Jpwolfe9912/Autodrone_V2/PNGs/3D_Front.png

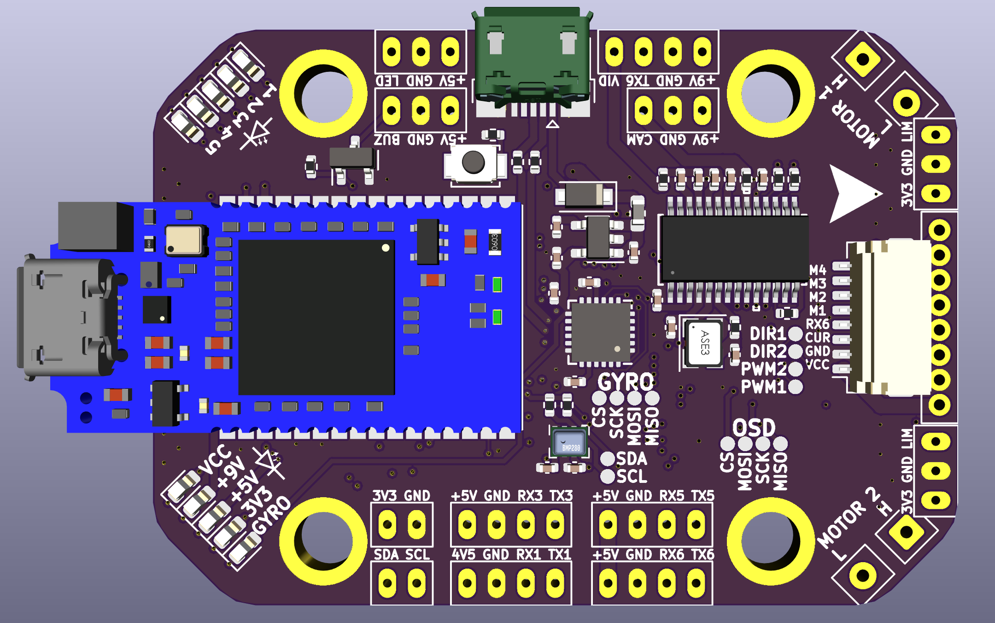
PNGs/3D_Front.png
