Jpwolfe9912/Autodrone_V2/README.md

# F722 Flight Controller V4
3D_Front
3D_Back
