Jpwolfe9912/Autodrone_V2/PNGs/3D_Back.png

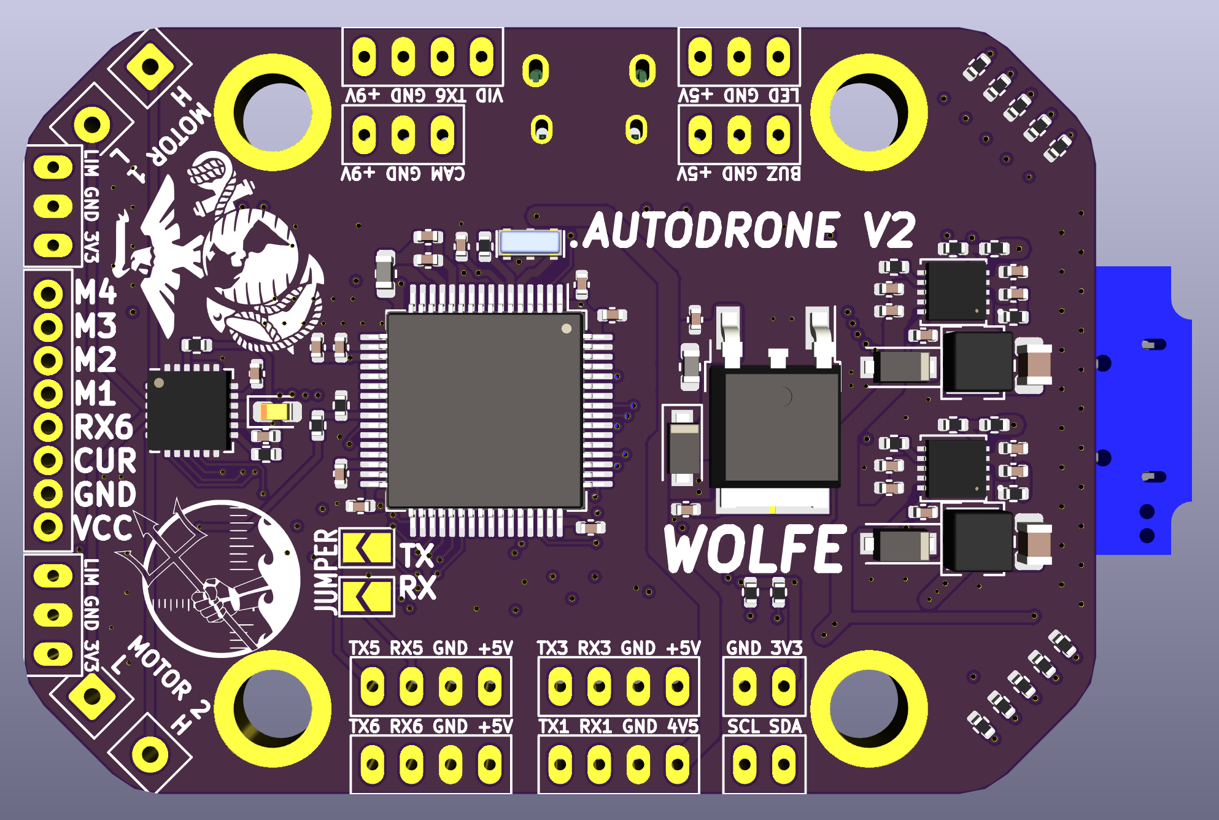
PNGs/3D_Back.png
