Jpwolfe9912/Autodrone_V2/PNGs/BMP280.png

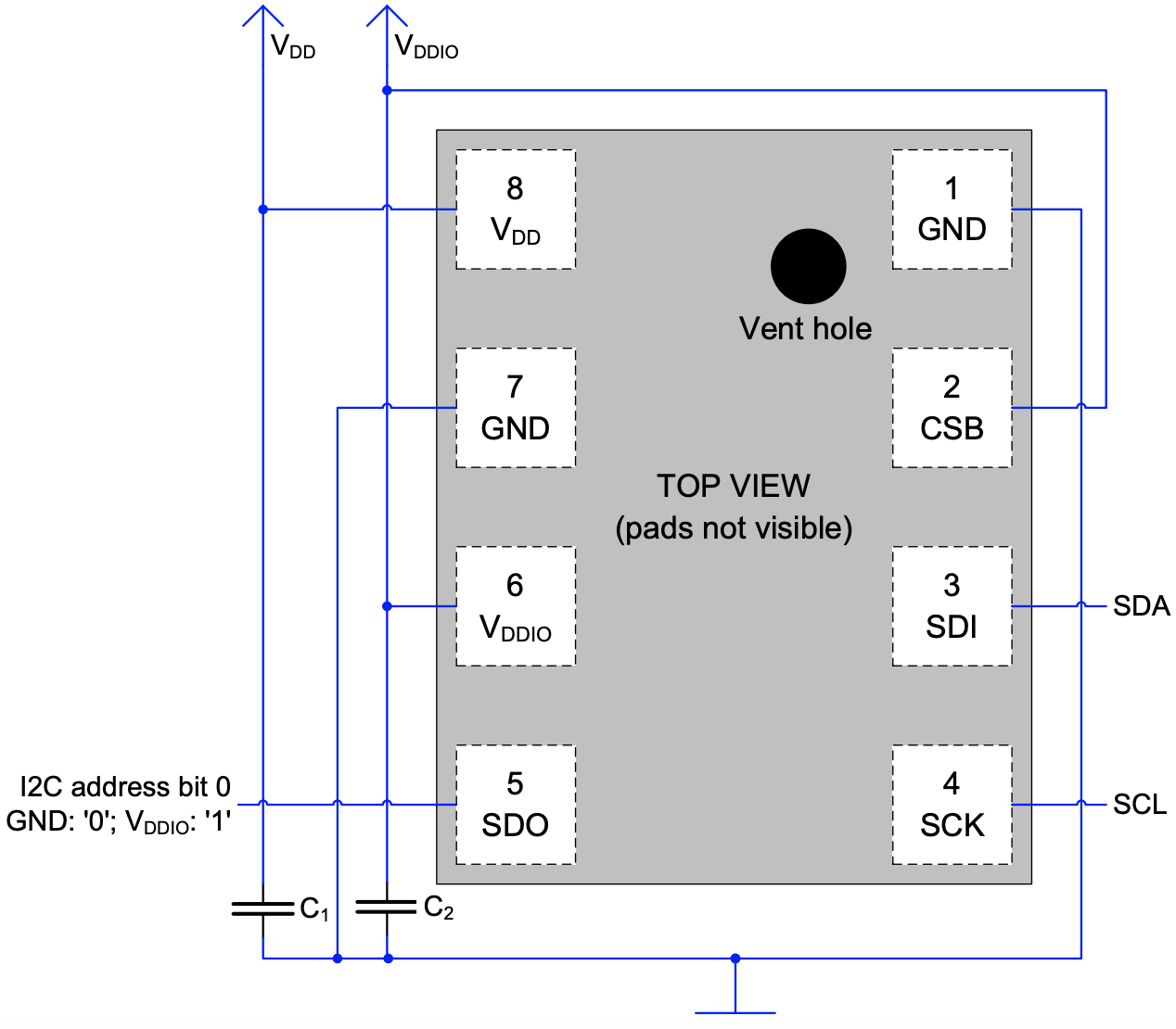
PNGs/BMP280.png
