Jpwolfe9912/Autodrone_V2/PNGs/DRV8424.png

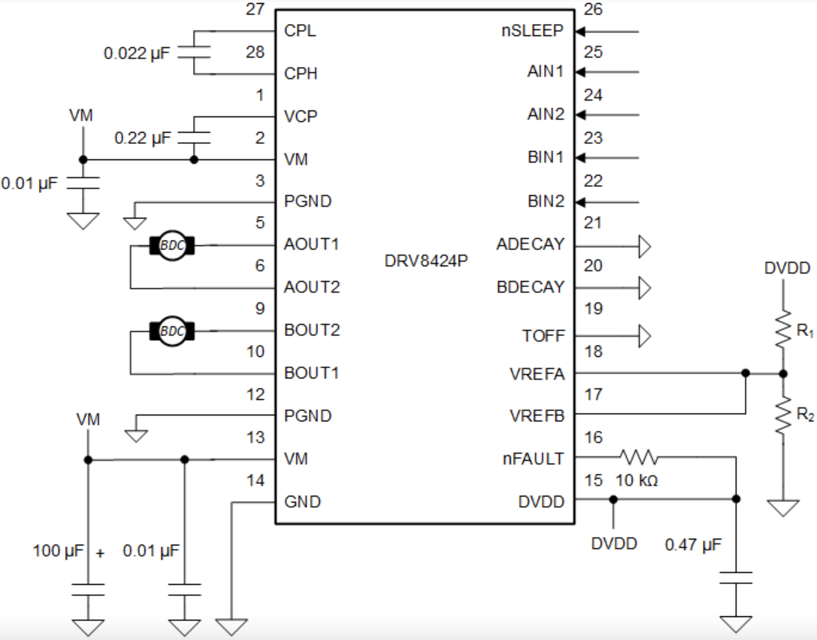
PNGs/DRV8424.png
