Jpwolfe9912/Autodrone_V2/PNGs/DRV8834_Schematic.png

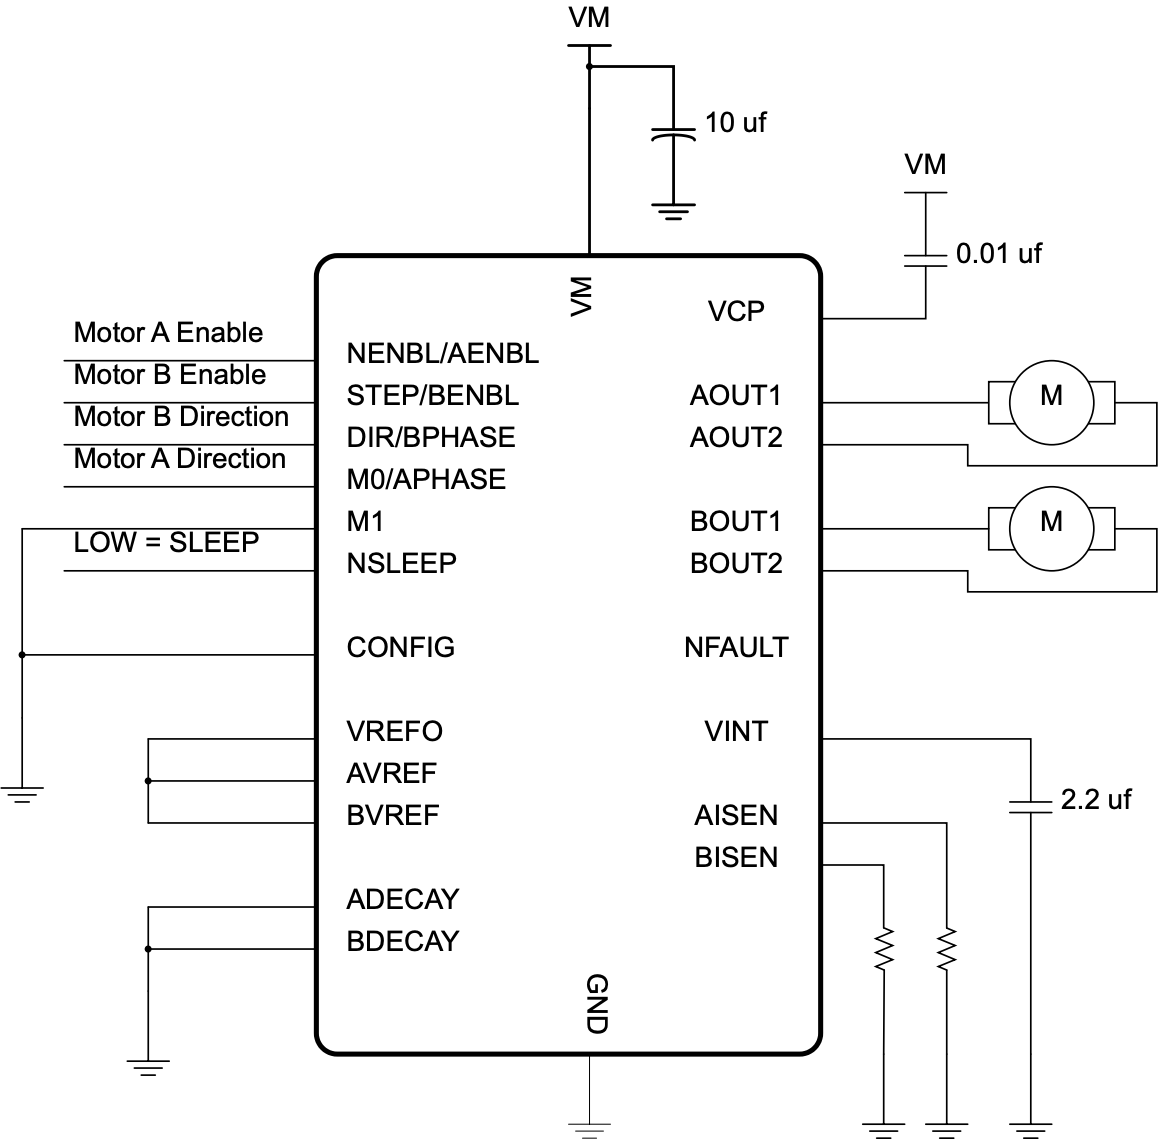
PNGs/DRV8834_Schematic.png
