Jpwolfe9912/Autodrone_V2/PNGs/ICM-20948.png

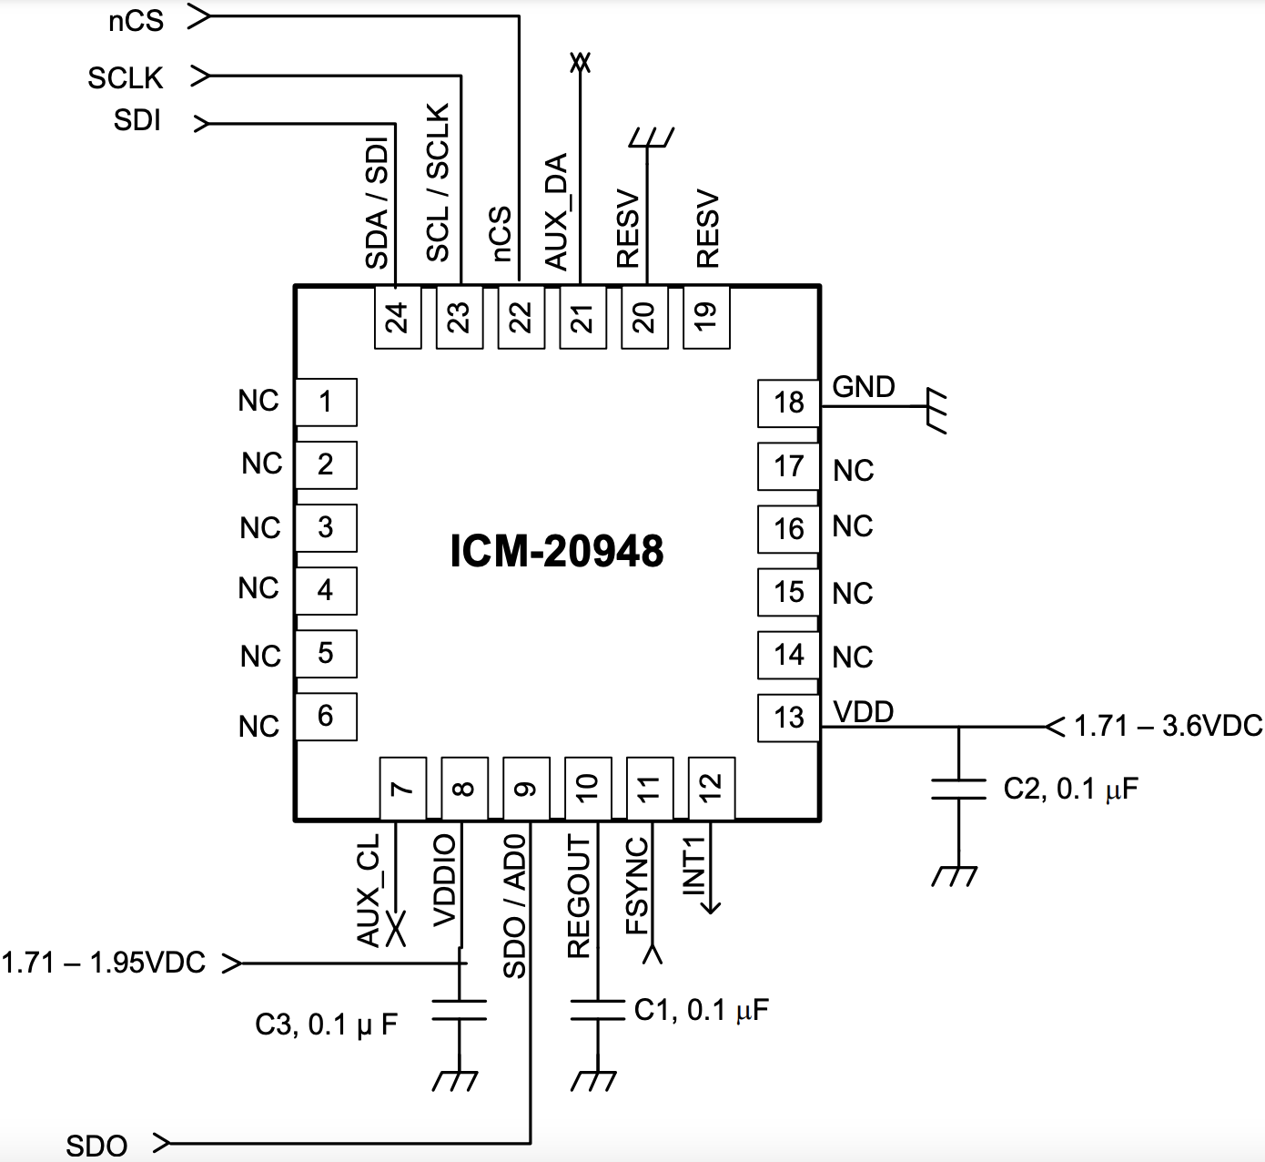
PNGs/ICM-20948.png
