Jpwolfe9912/Autodrone_V2/PNGs/MP4560_5V.png

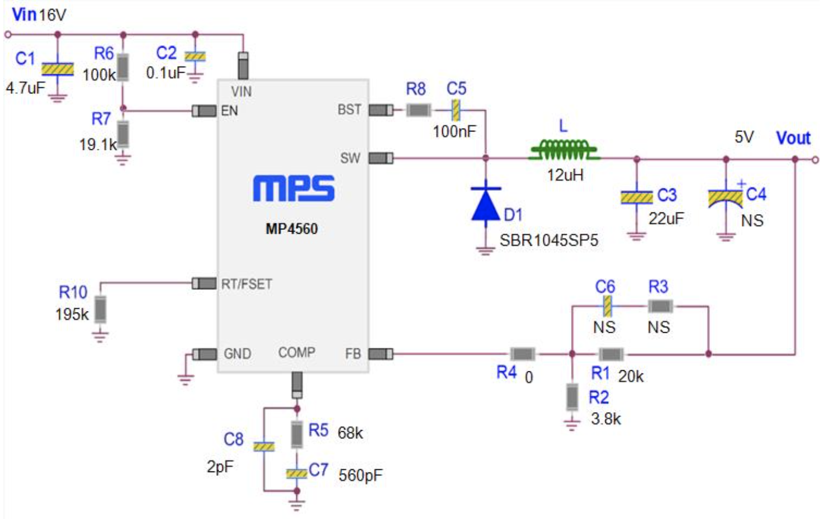
PNGs/MP4560_5V.png
