Jpwolfe9912/Autodrone_V2/PNGs/Pinout.png

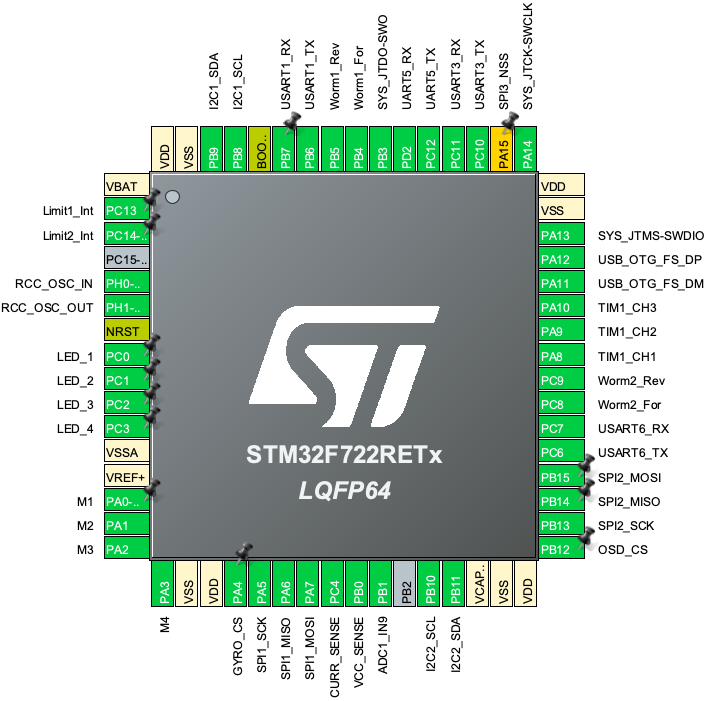
PNGs/Pinout.png
