Jpwolfe9912/Autodrone_V2/PNGs/SN74AXC4T774.png

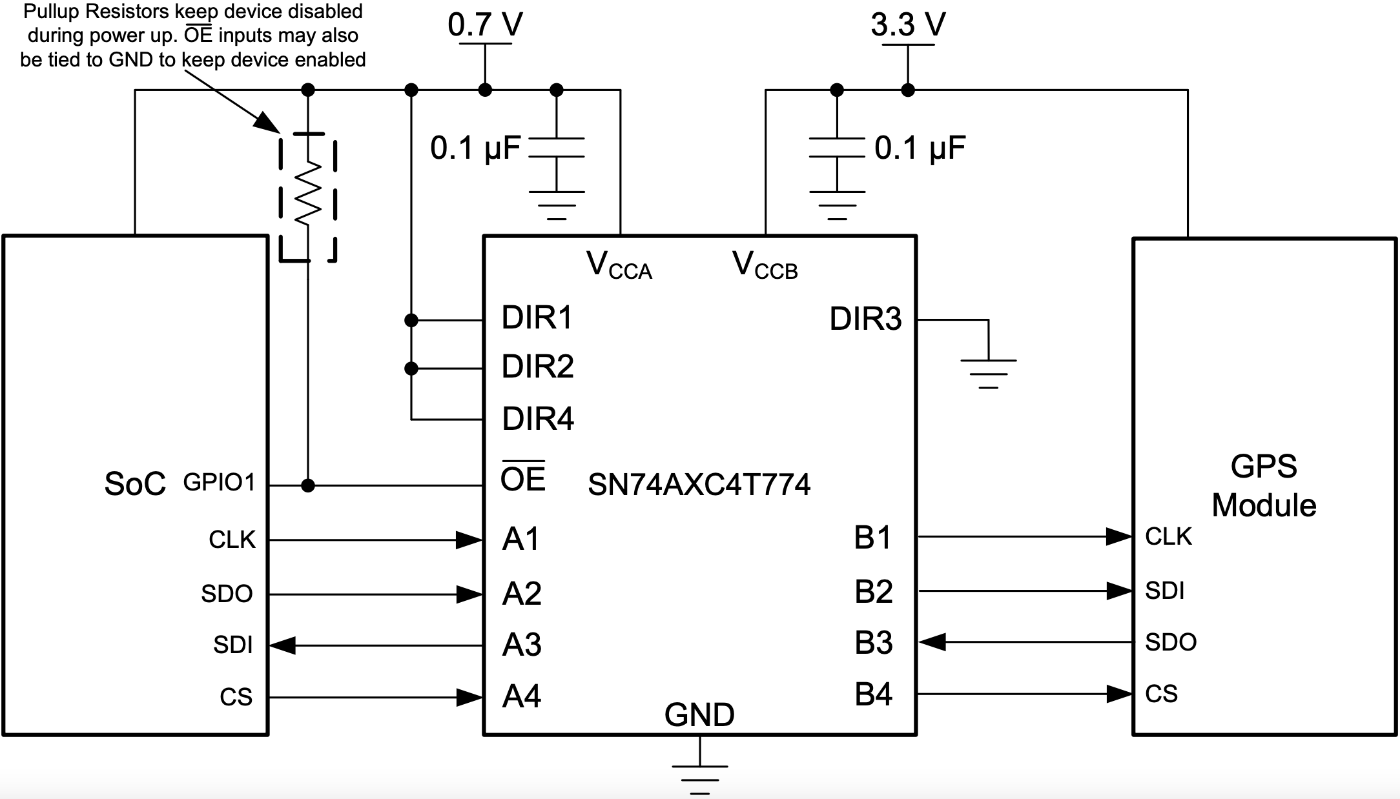
PNGs/SN74AXC4T774.png
