Jpwolfe9912/Autodrone_V2/PNGs/STLinkV3.png

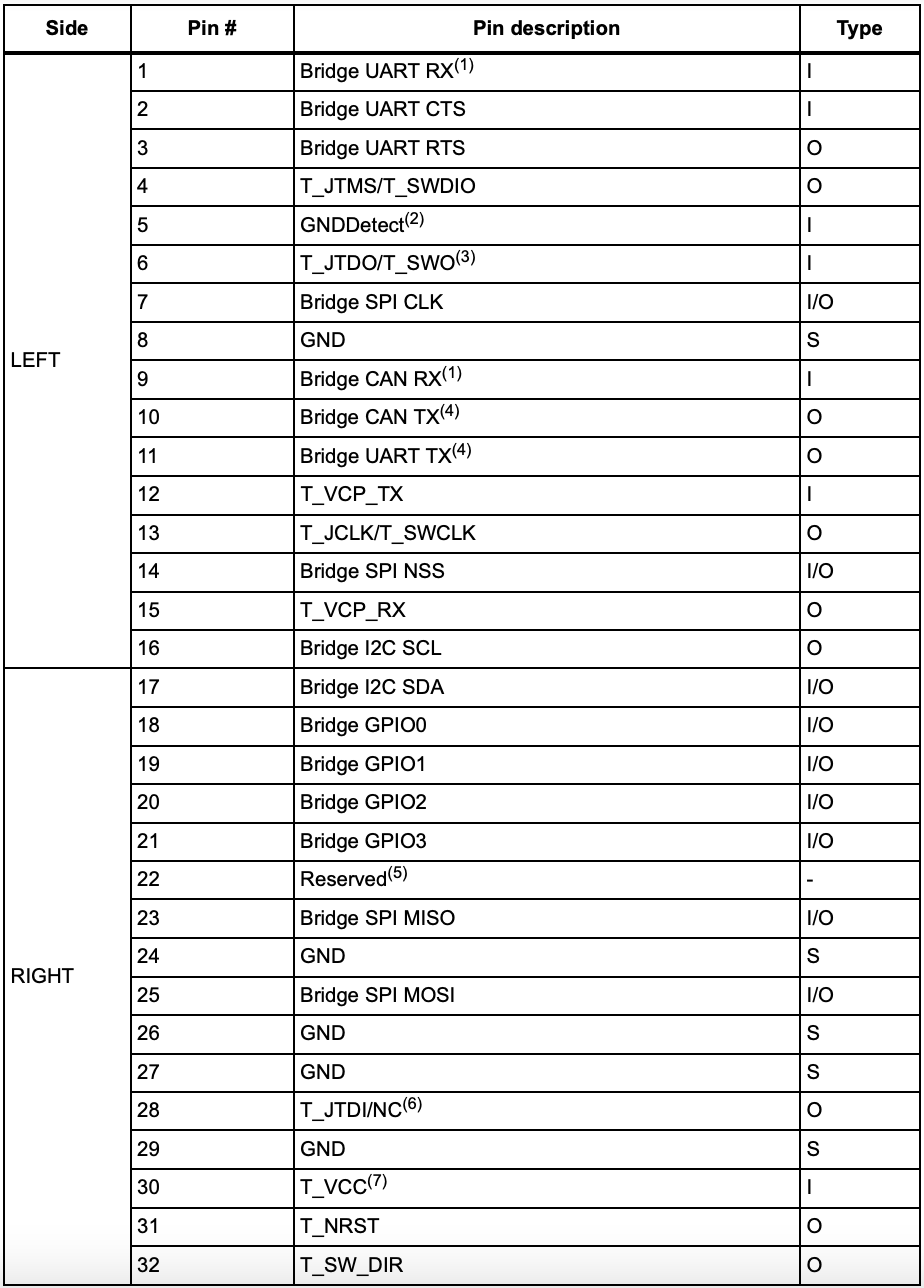
PNGs/STLinkV3.png
