Jpwolfe9912/Autodrone_V2/.\Board2Pdf/Autodrone_V2-Assembly.pdf

VCC | WOLFE JUMPER | TXRX 1 | 2 | 3 | 4 | 5 | 6 1 | 2 | 3 | 4 | 5 | 6 ABCD | ABCD Date: KiCad E.D.A. kicad (6.0.0-0) Size: A4 | Rev:

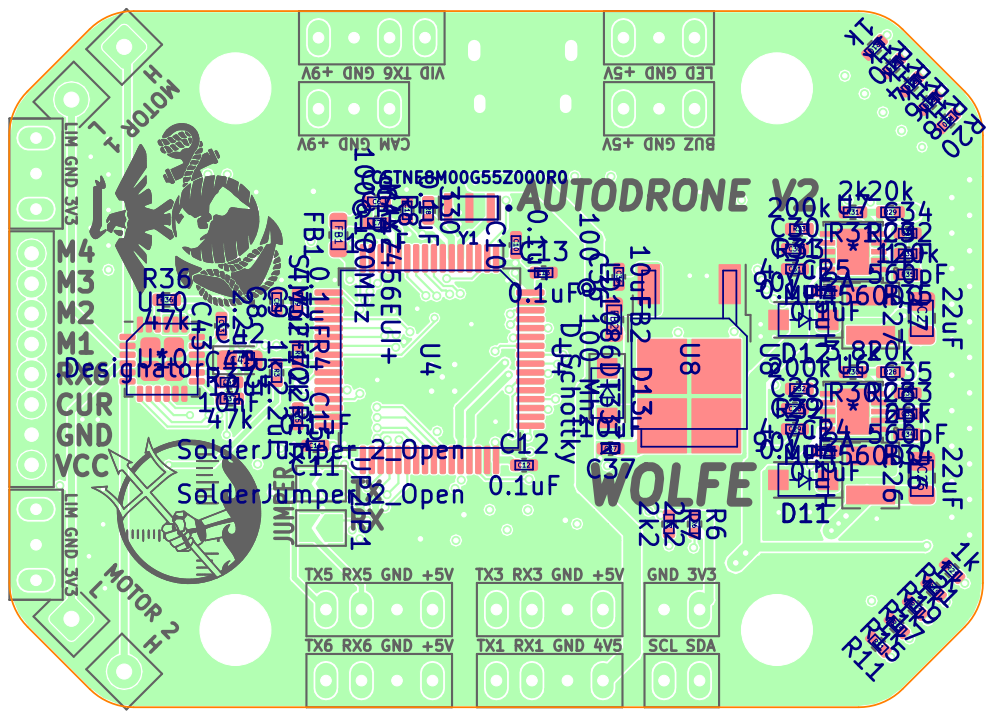
[picture p11: page 1]

1 | 2 | 3 | 4 | 5 | 6

A

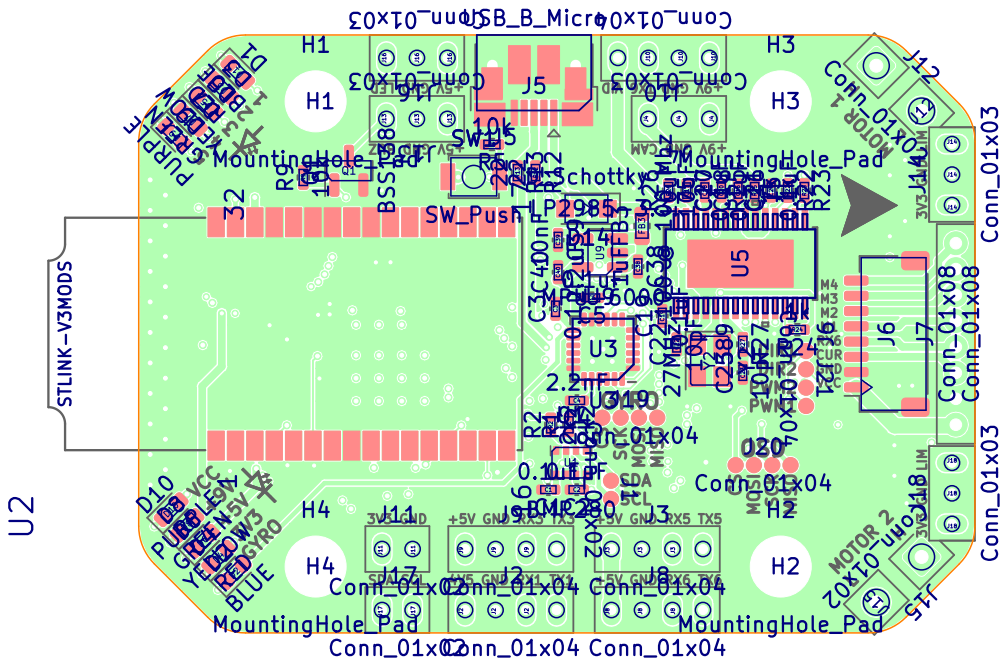
[picture p12: page 2]

C2 R² 2k2R² R¹² ²²R¹² R¹³ ²²R¹³ J5 USB_B_Micro

VCC CS MOSI SCK MISO

MOTOR 2 L H CS SCK MOSI MISO
