Jpwolfe9912/Autodrone_V2/PNGs/Autodrone_V2.pdf

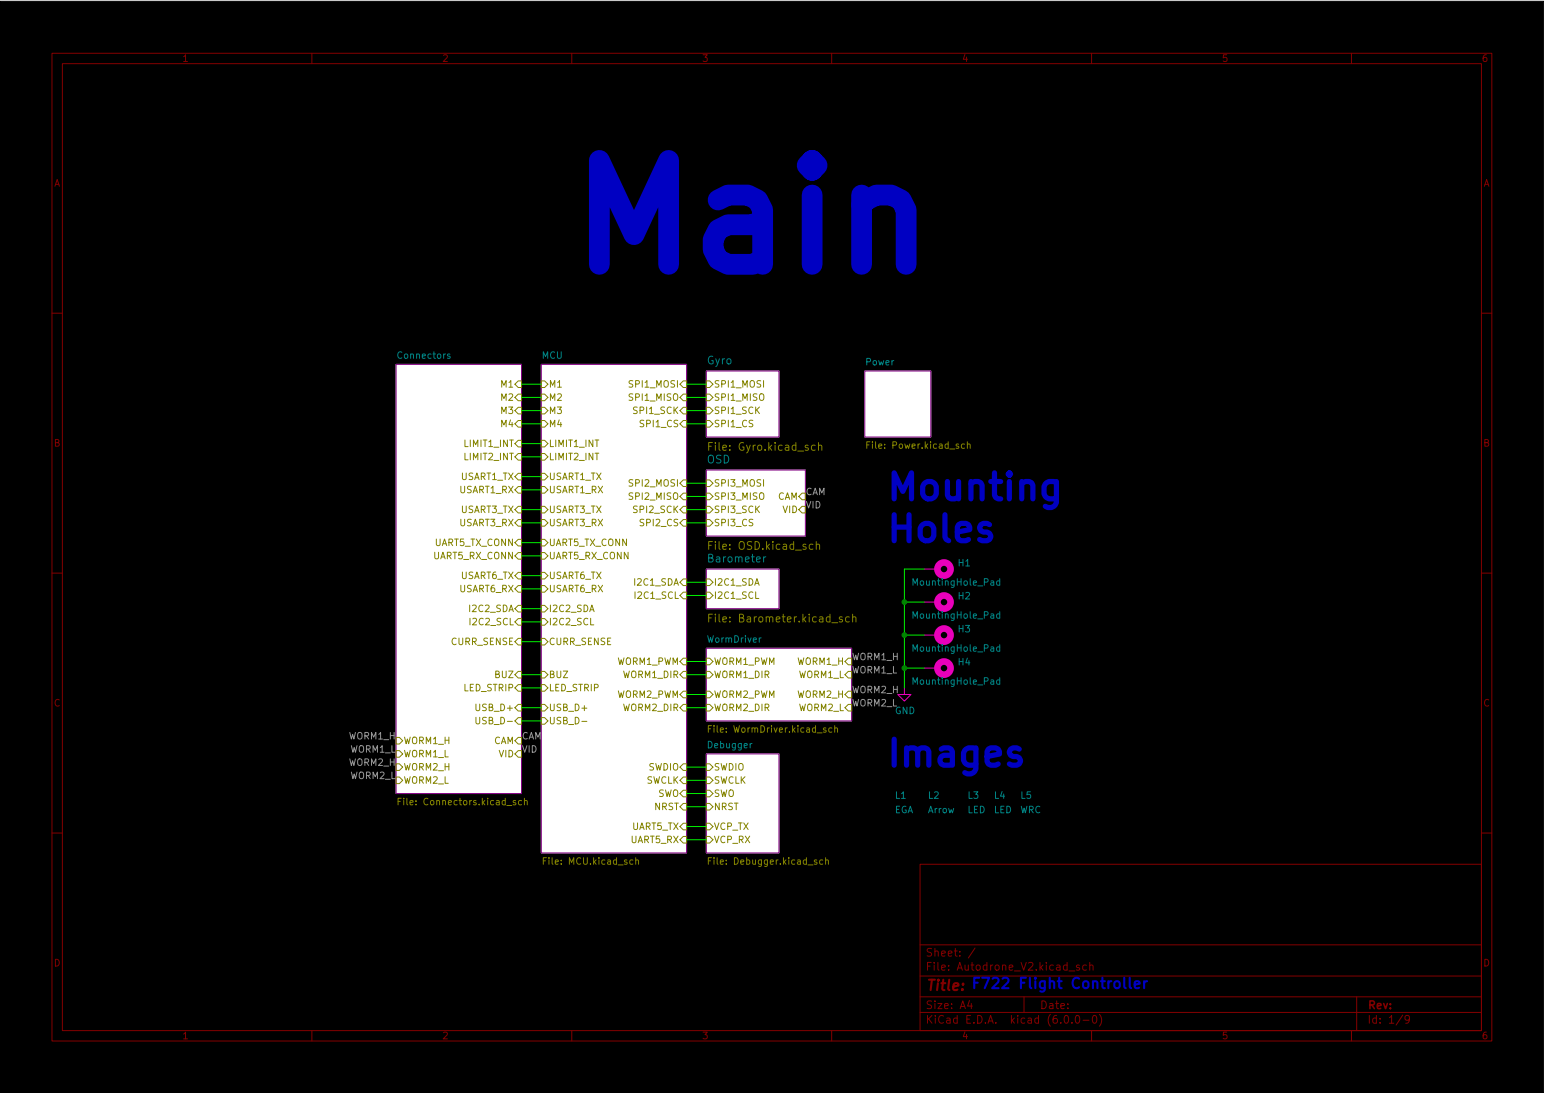
[picture p13: page 1]

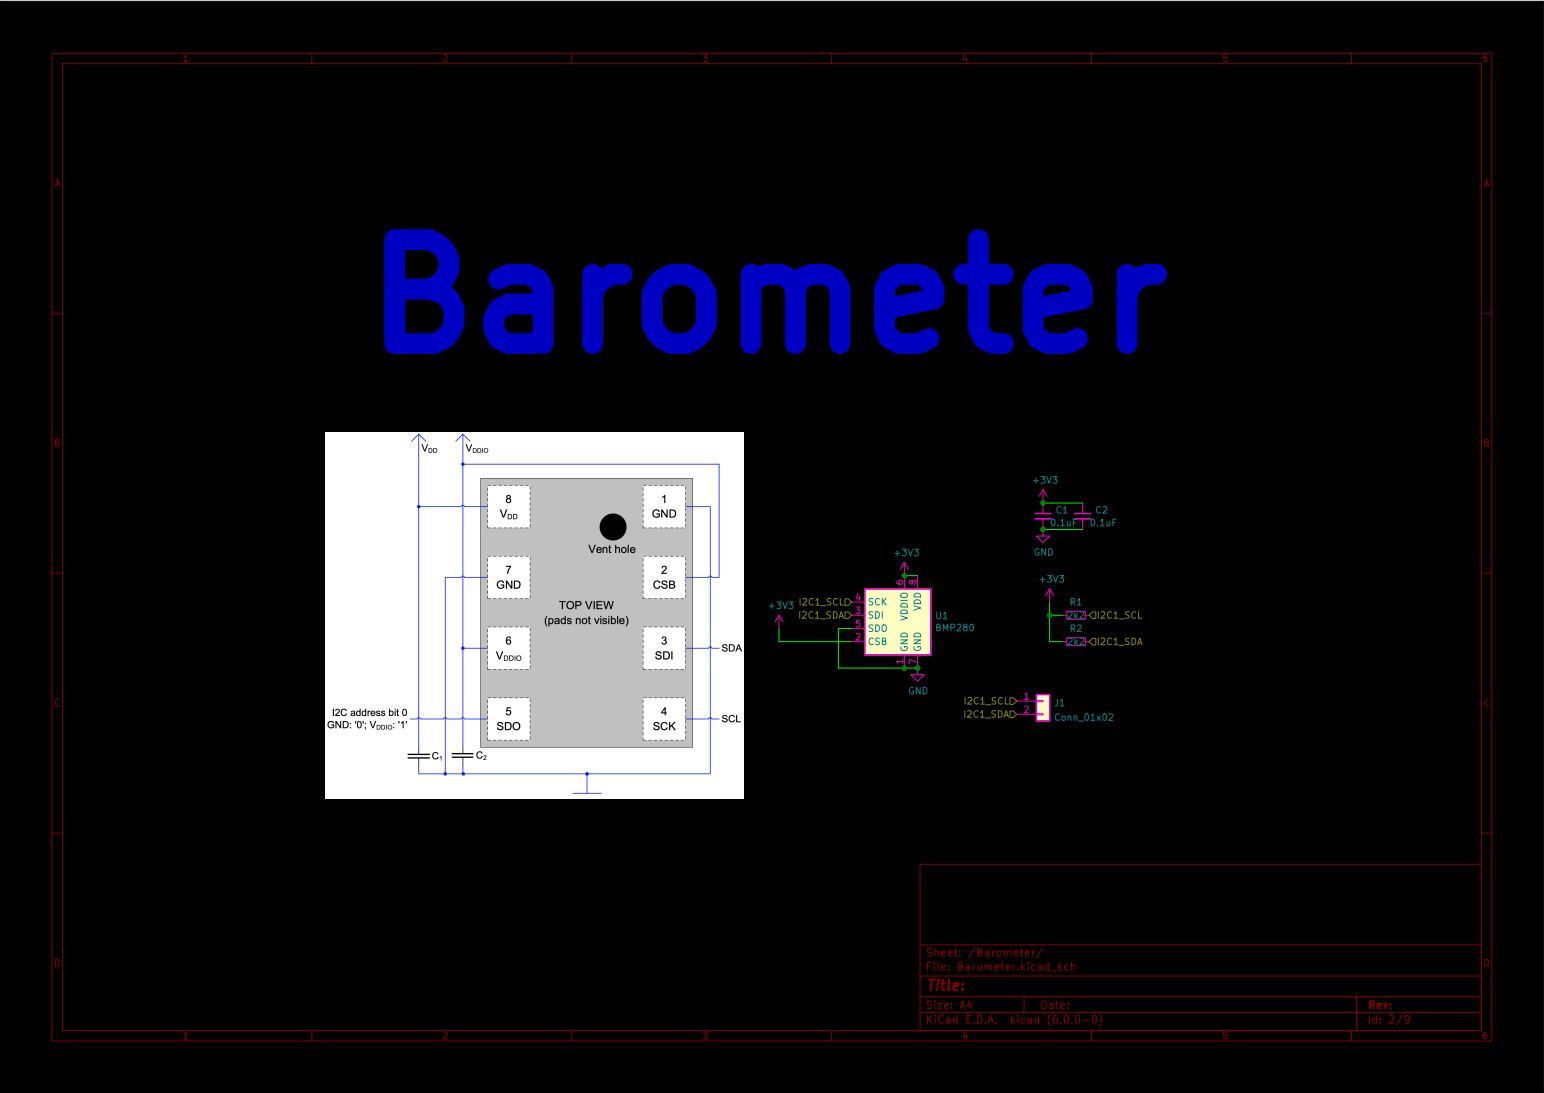
[picture p14: page 2]

1 CSB 2 SDI 3 SCK 4 SDO 5 VDDIO

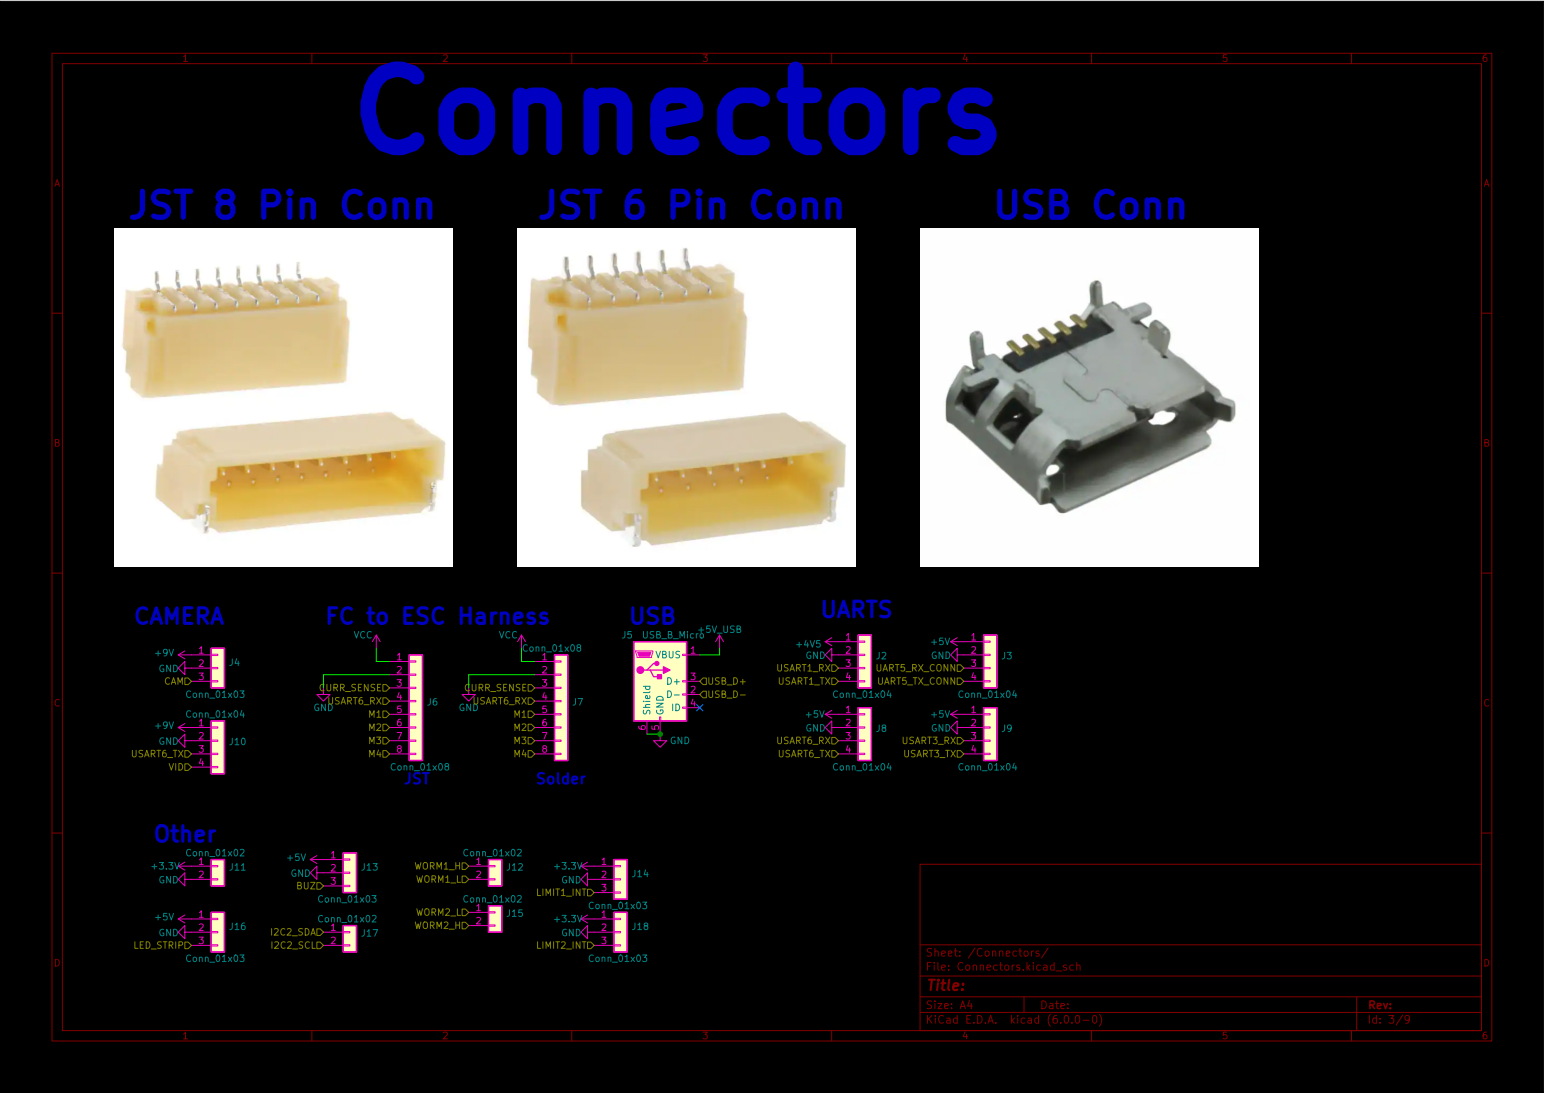
[picture p15: page 3]

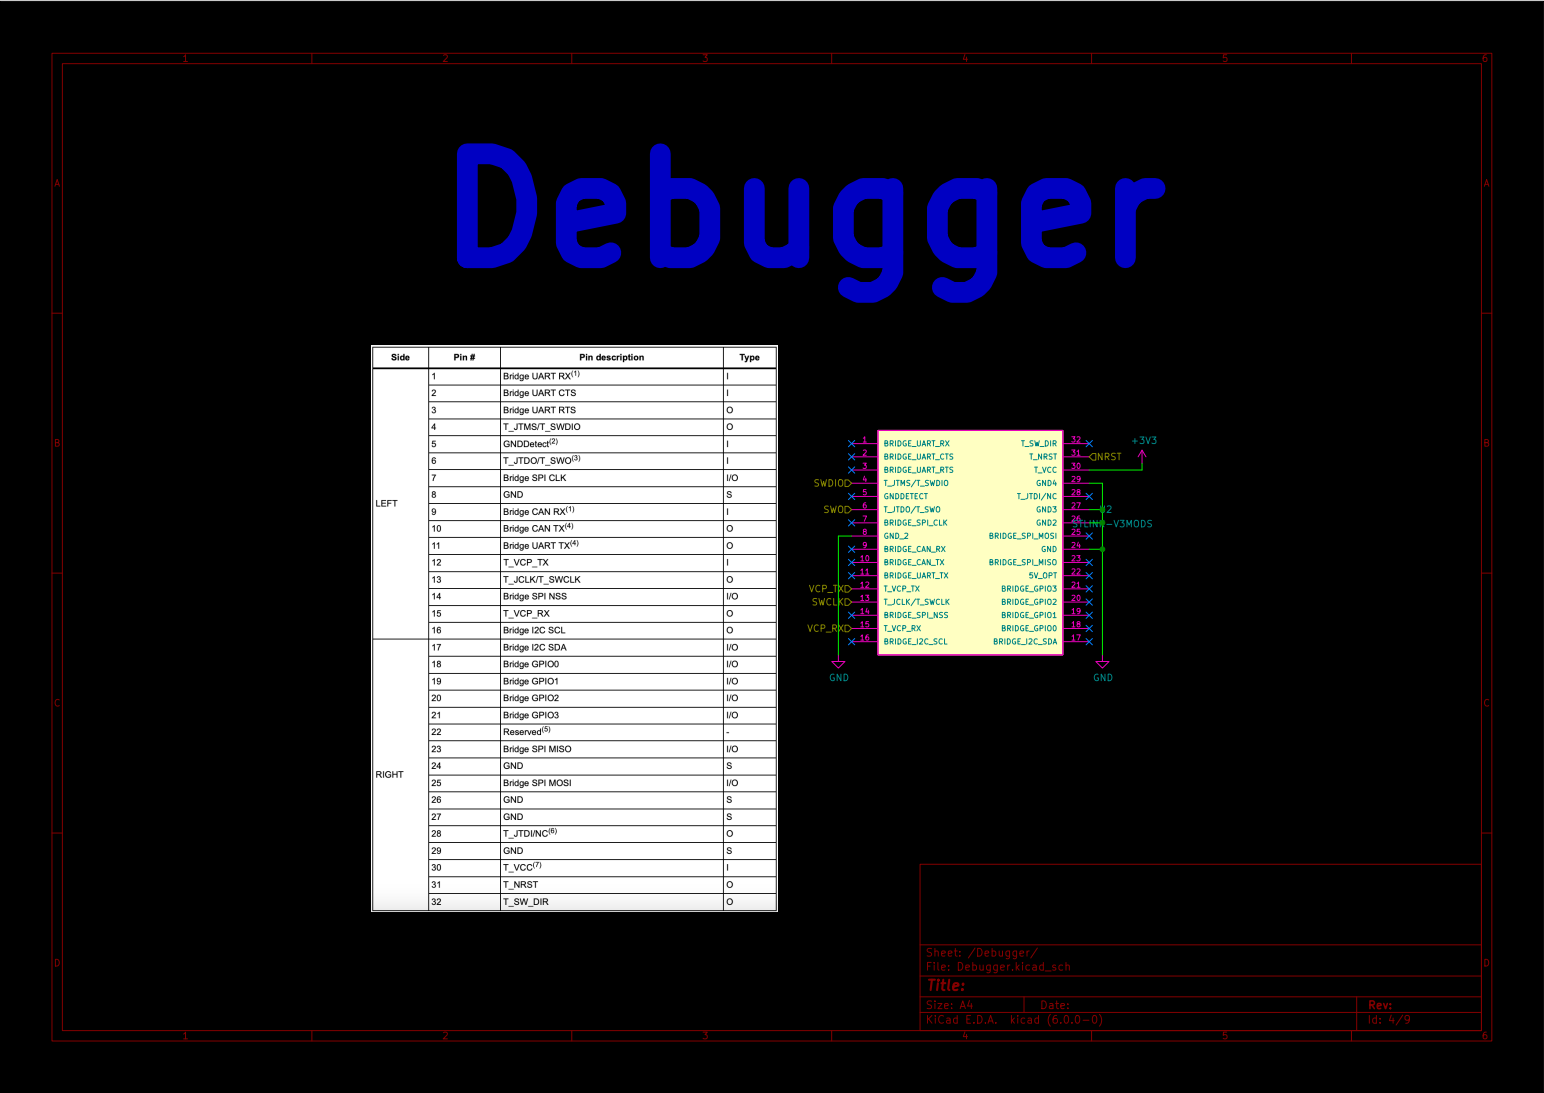
[picture p16: page 4]

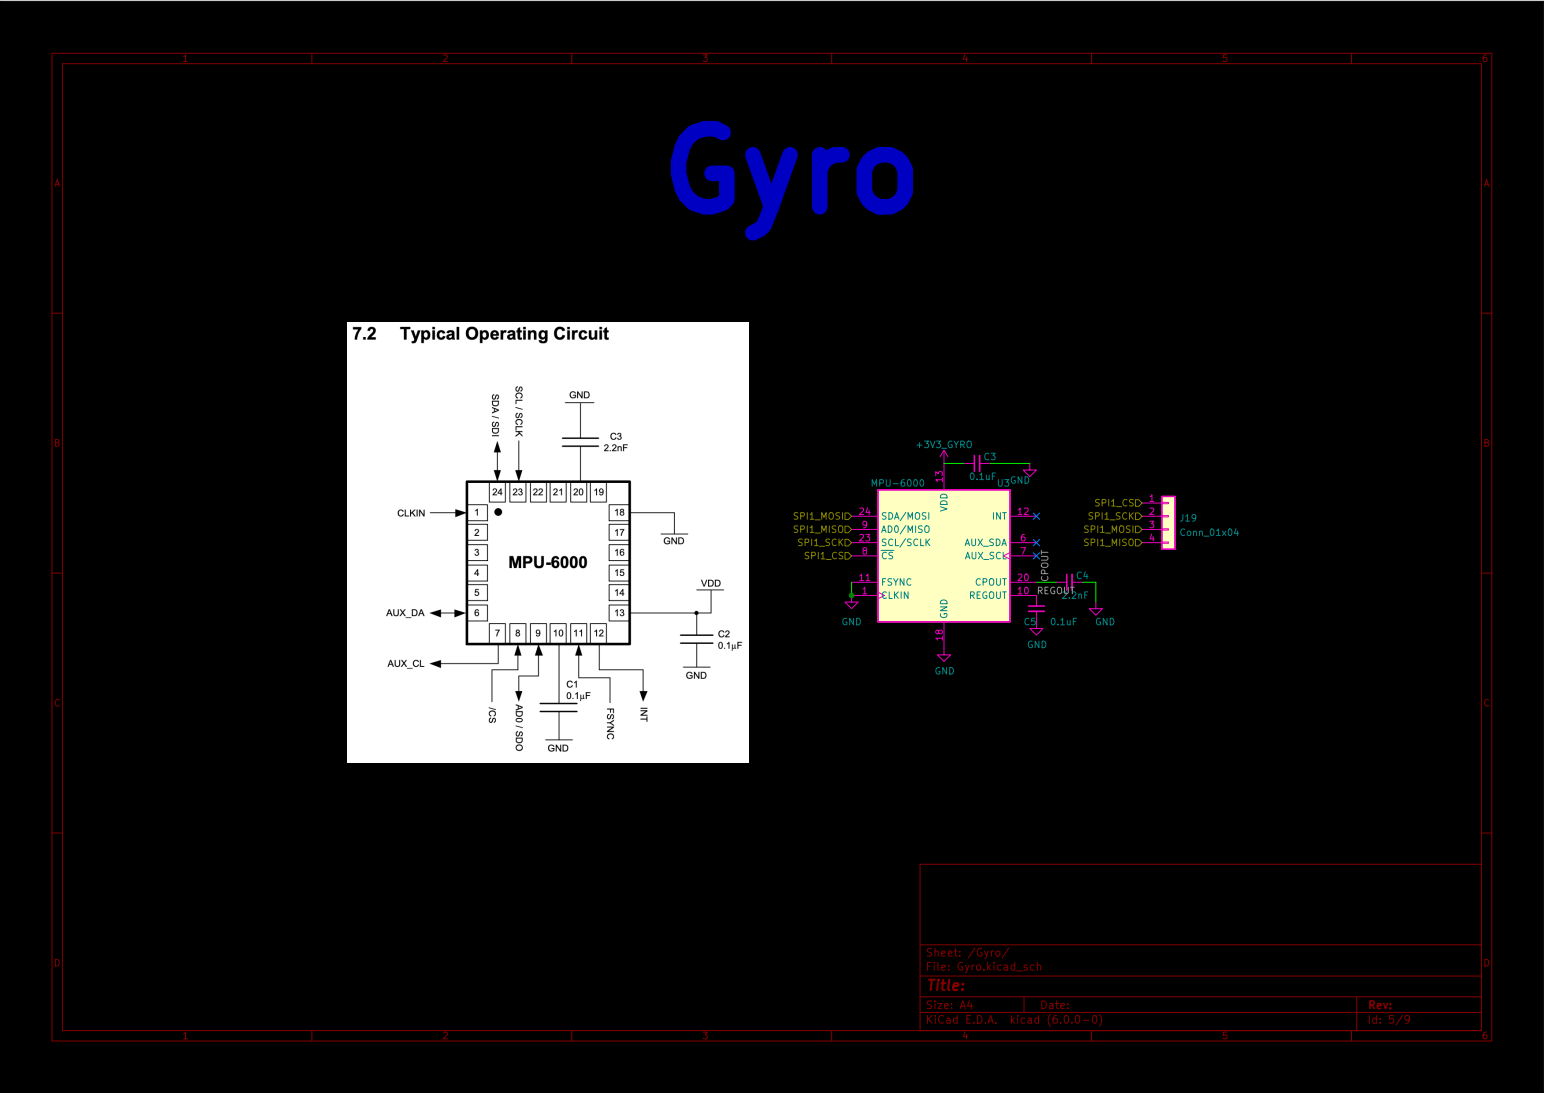
[picture p17: page 5]

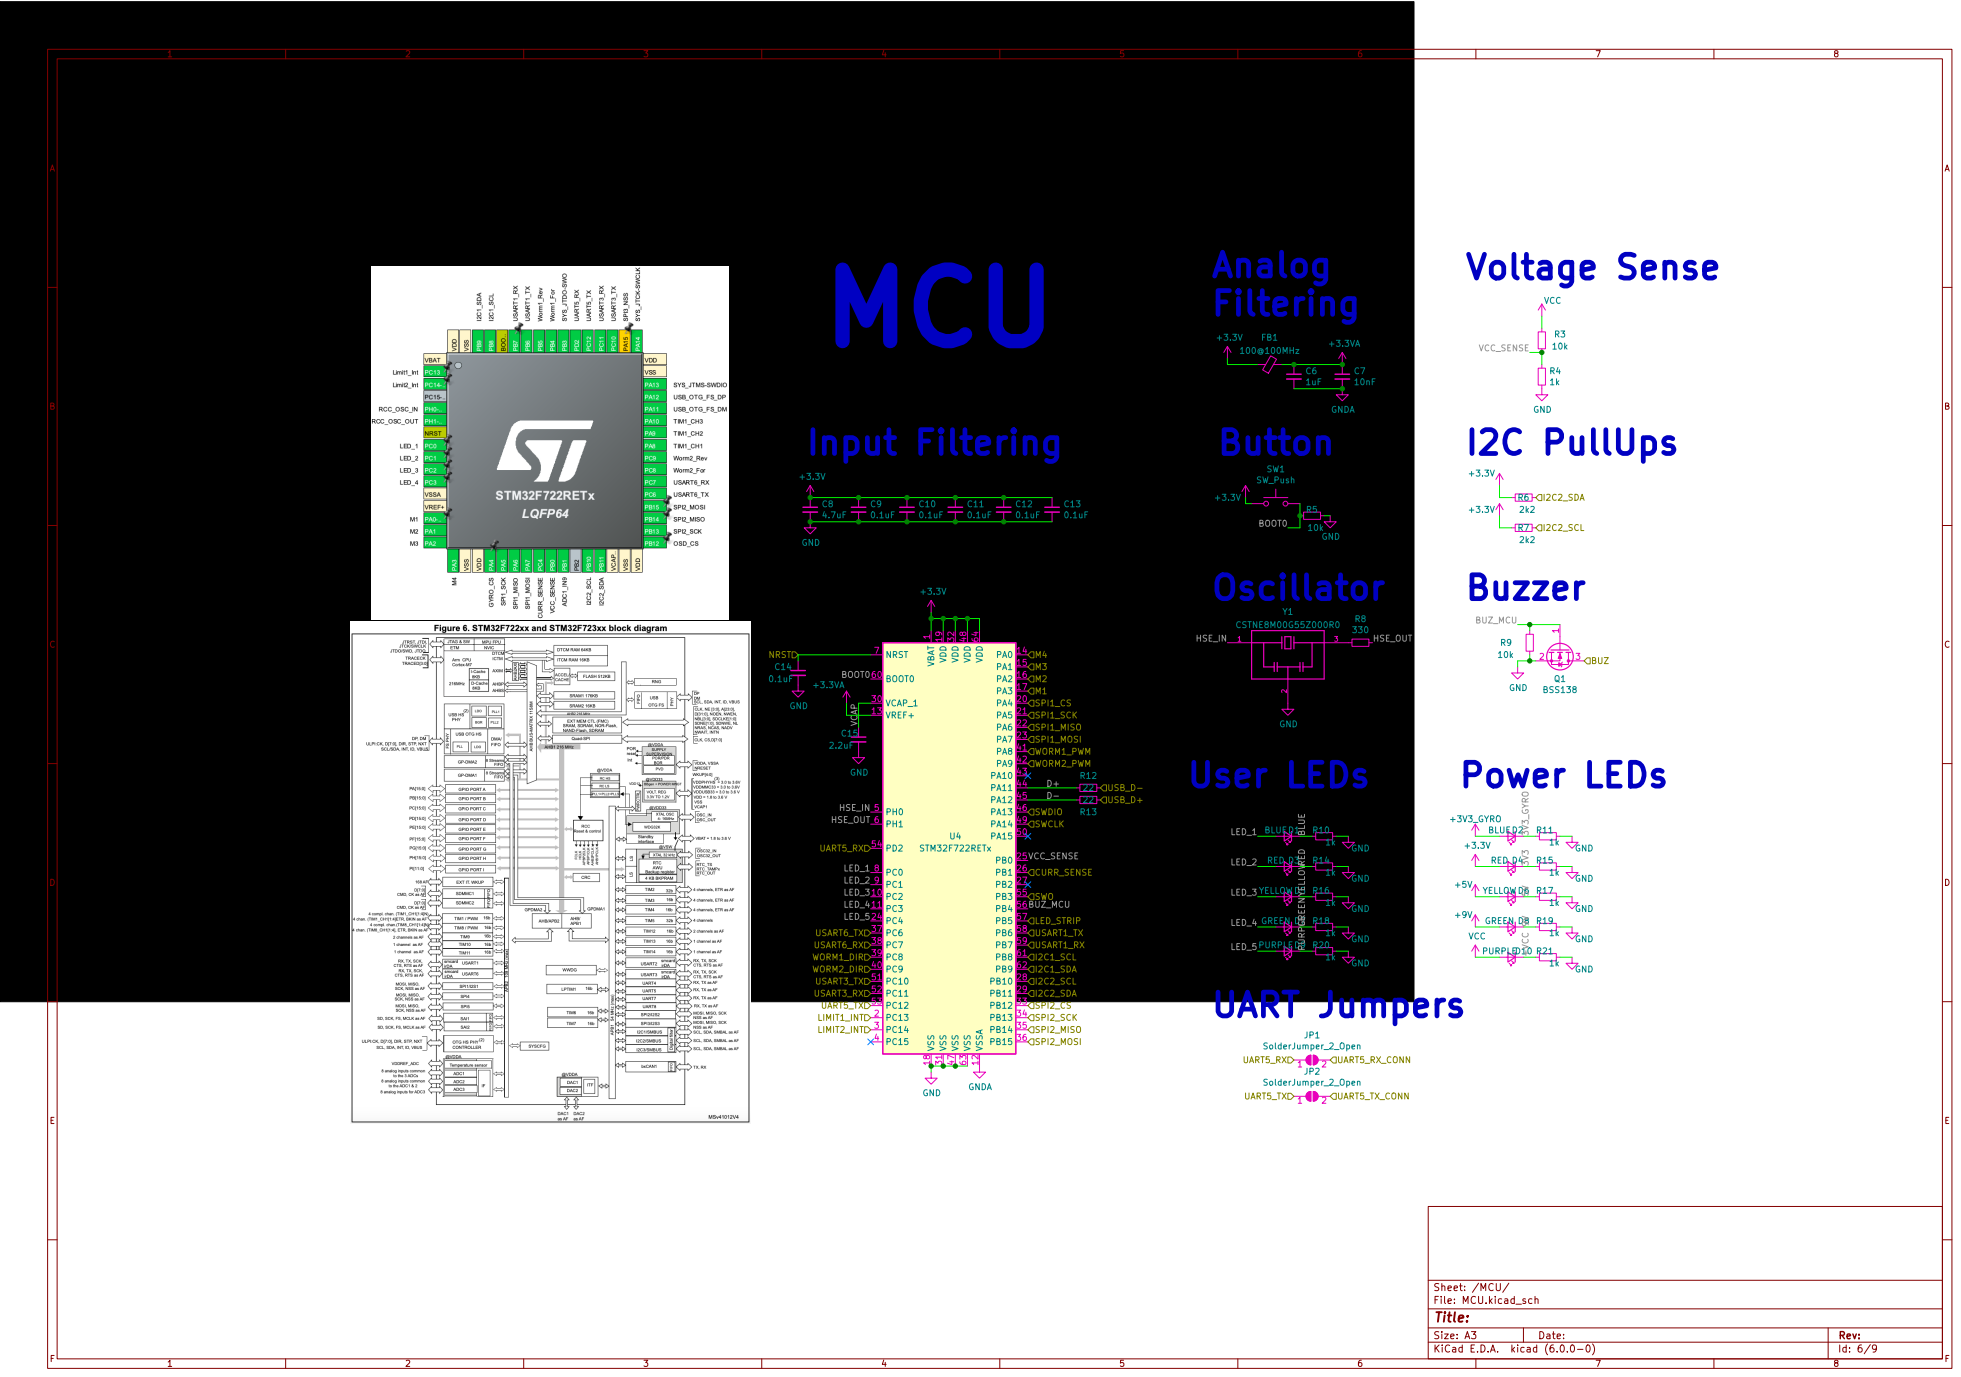
[picture p18: page 6]

Id: 6/9 Title: File: MCU.kicad_sch Sheet: /MCU/

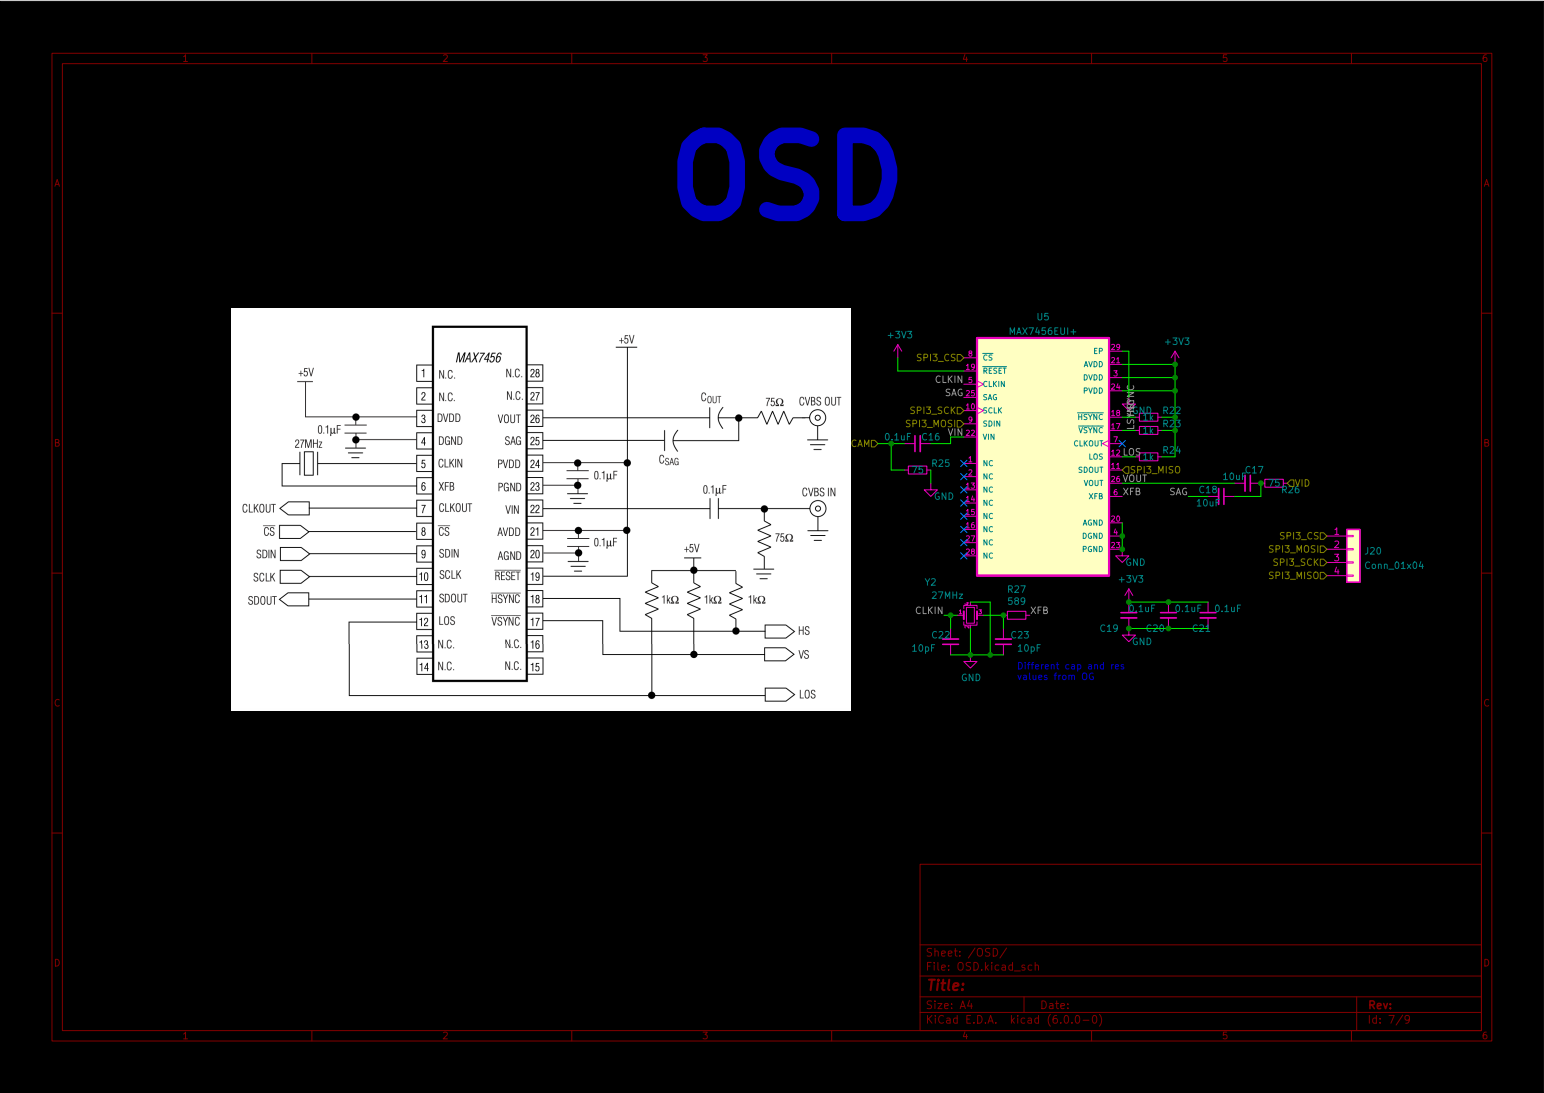
[picture p19: page 7]

Different cap and res values from OG OSD

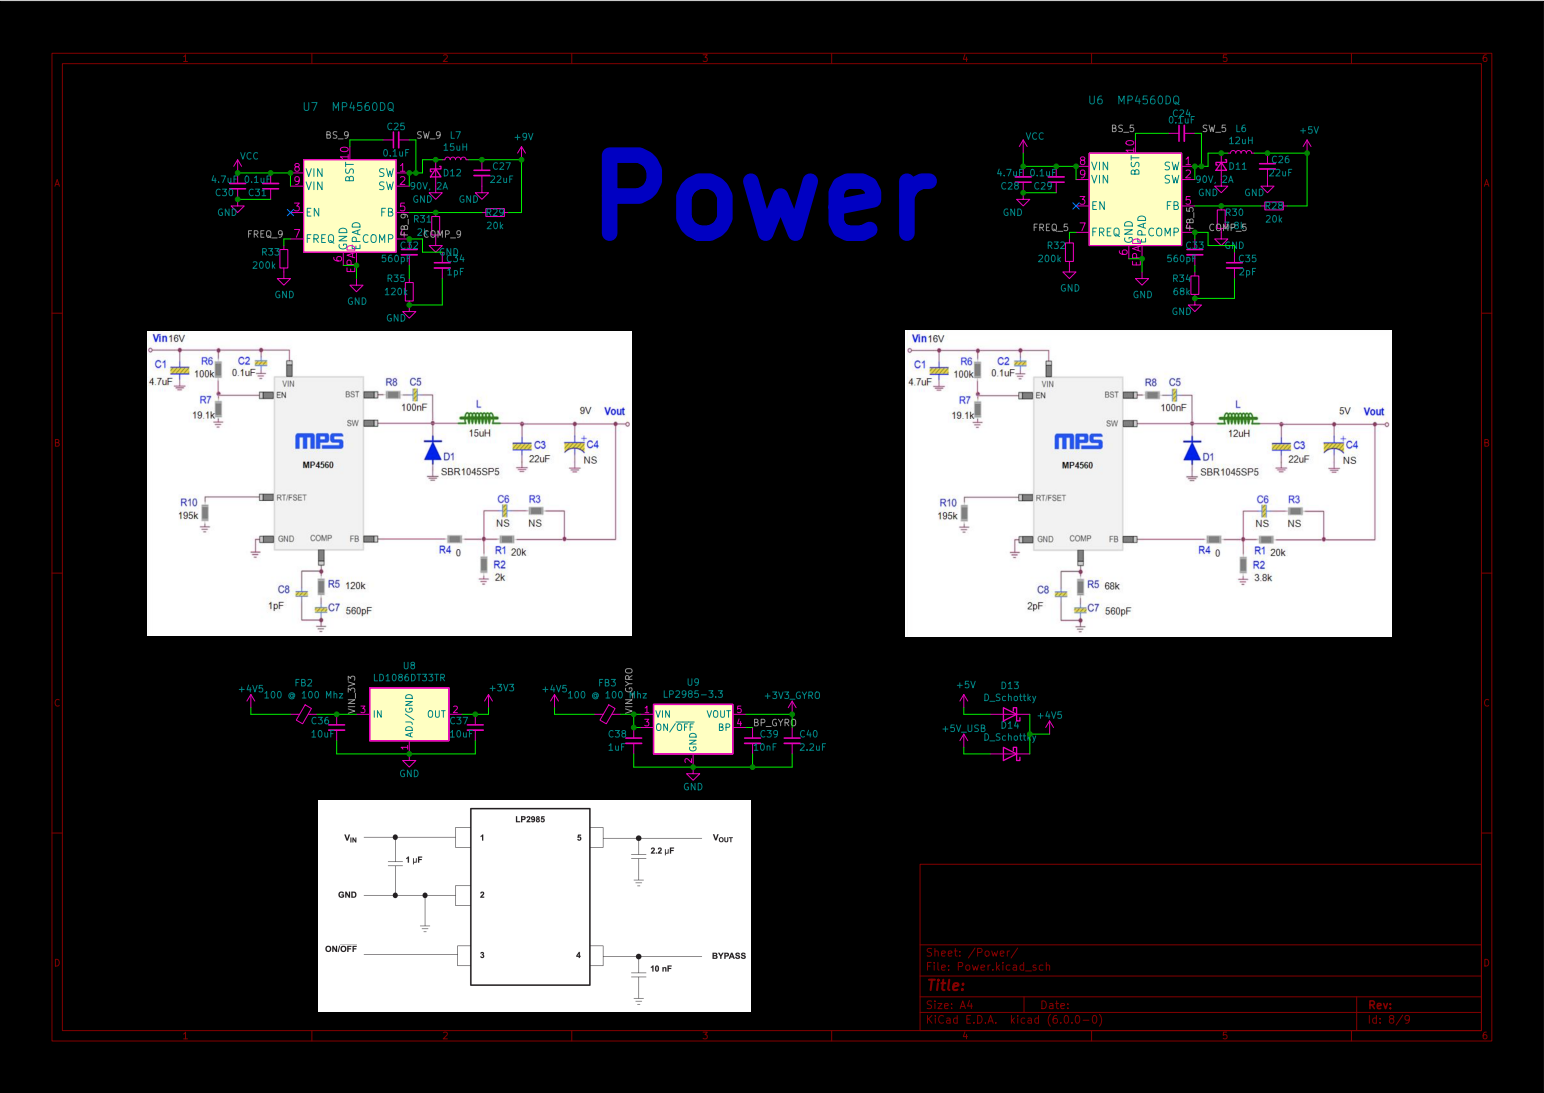
[picture p20: page 8]

6 FREQ 7 VIN 8 VIN 9 EPAD EPAD U6 MP4560DQ
12uH GND

6 FREQ 7 VIN 8 VIN 9 EPAD EPAD U7 MP4560DQ
COMP_9 VIN_3V3

2 ON/~{OFF} 3 BP 4 VOUT 5 U9

File: Power.kicad_sch Sheet: /Power/
Id: 8/9 Title:

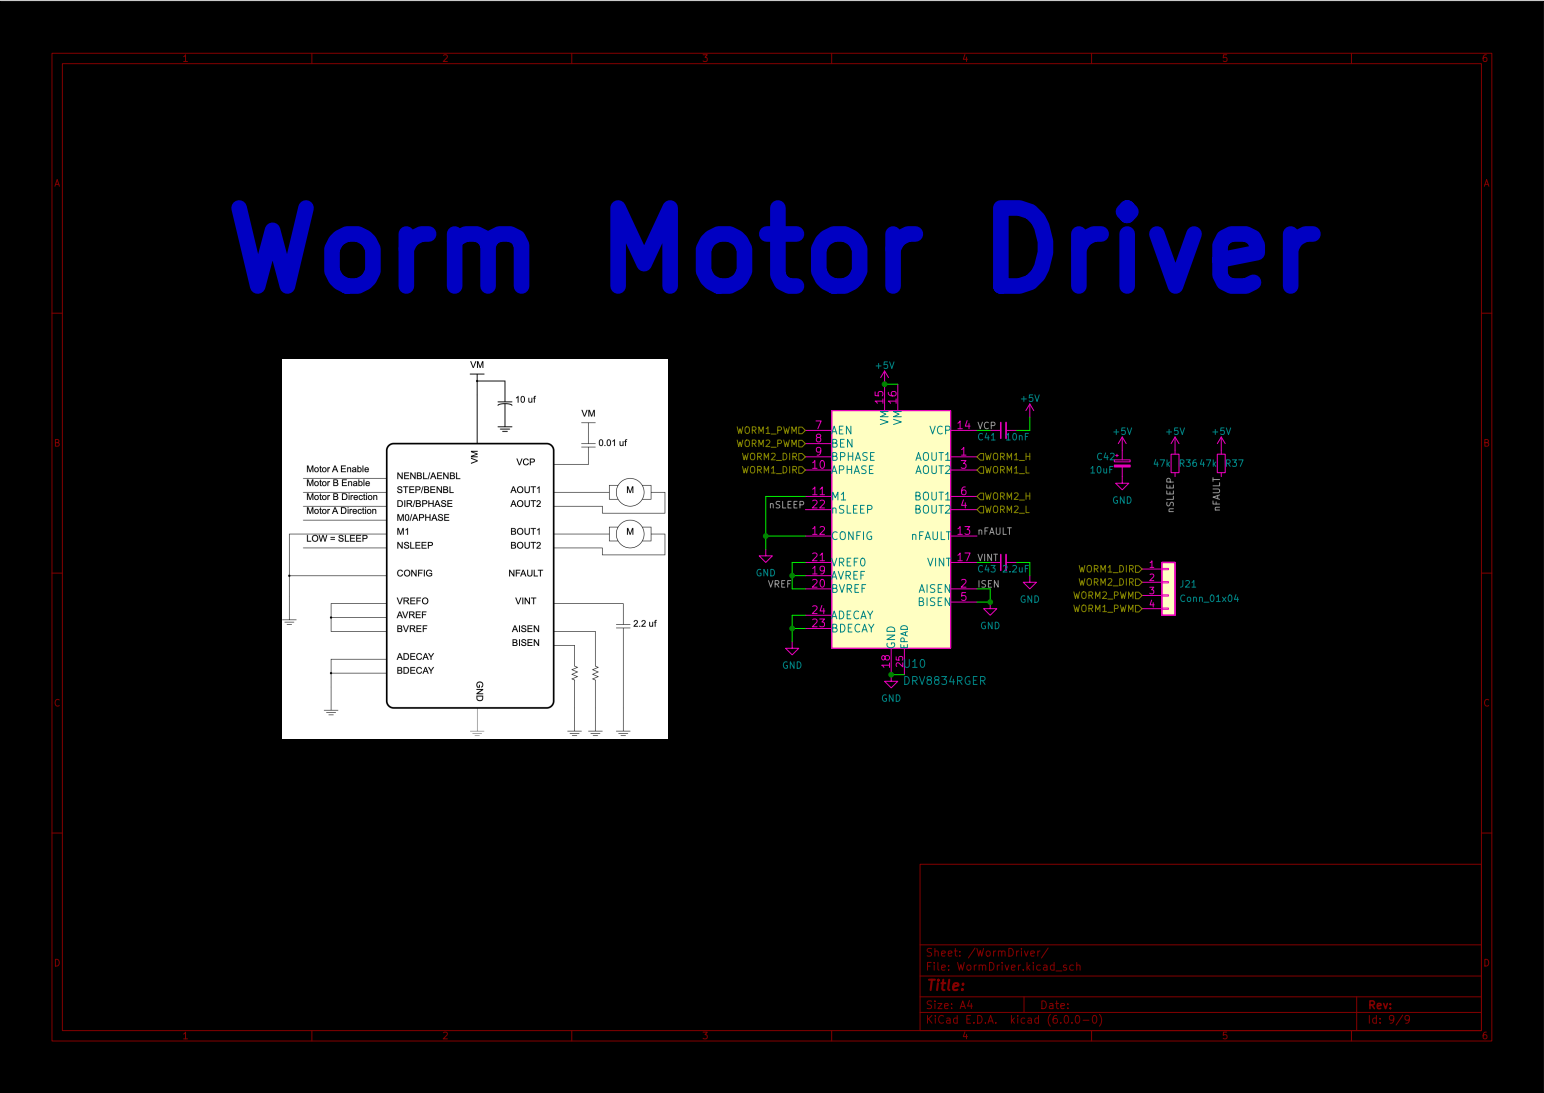
[picture p21: page 9]

File: WormDriver.kicad_sch Sheet: /WormDriver/
Id: 9/9 Title:
