Jpwolfe9912/Autodrone_V2/Autodrone_V2.kicad_pcb

## KiCad design Autodrone_V2.kicad_pcb (2022-04-11)

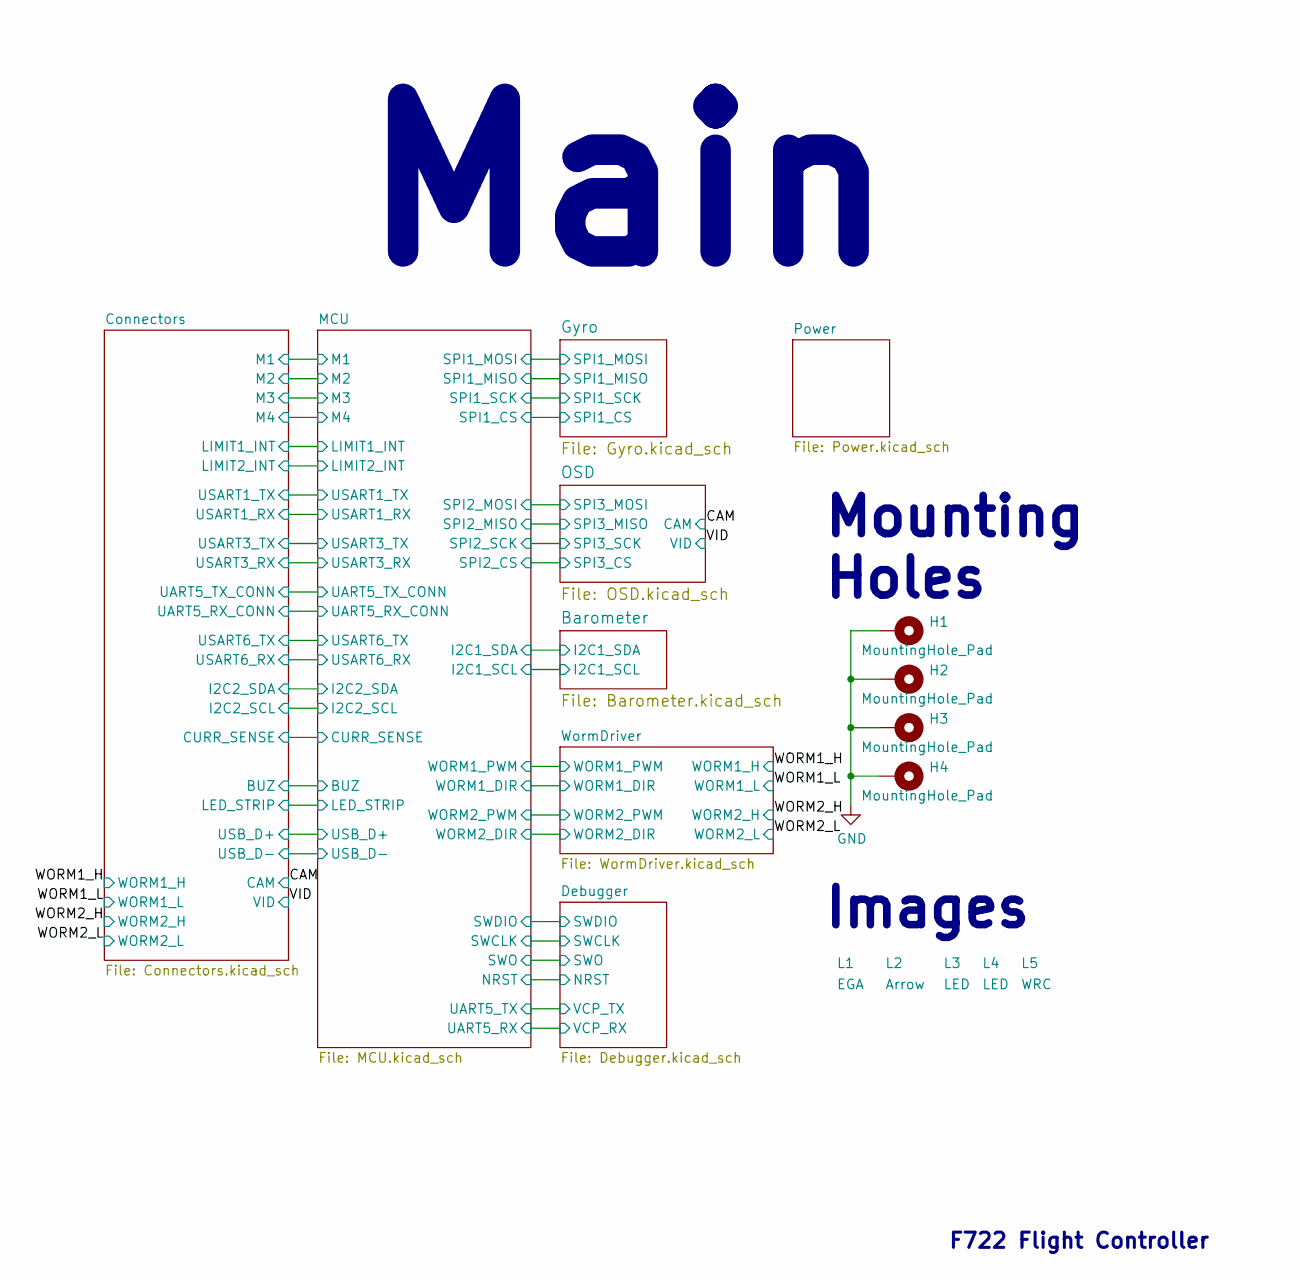
[picture p22: schematic Autodrone_V2.kicad_sch]

Parts:
H1, H2, H3, H4: MountingHole_Pad; MountingHole_6_4
L1: EGA
L2: Arrow
L3, L4: LED
L5: WRC; WRC2

Connections:
GND: H1.1, H2.1, H3.1, H4.1; also elsewhere on the board

Notes on the sheet:
Mounting Holes
Images
F722 Flight Controller
Main

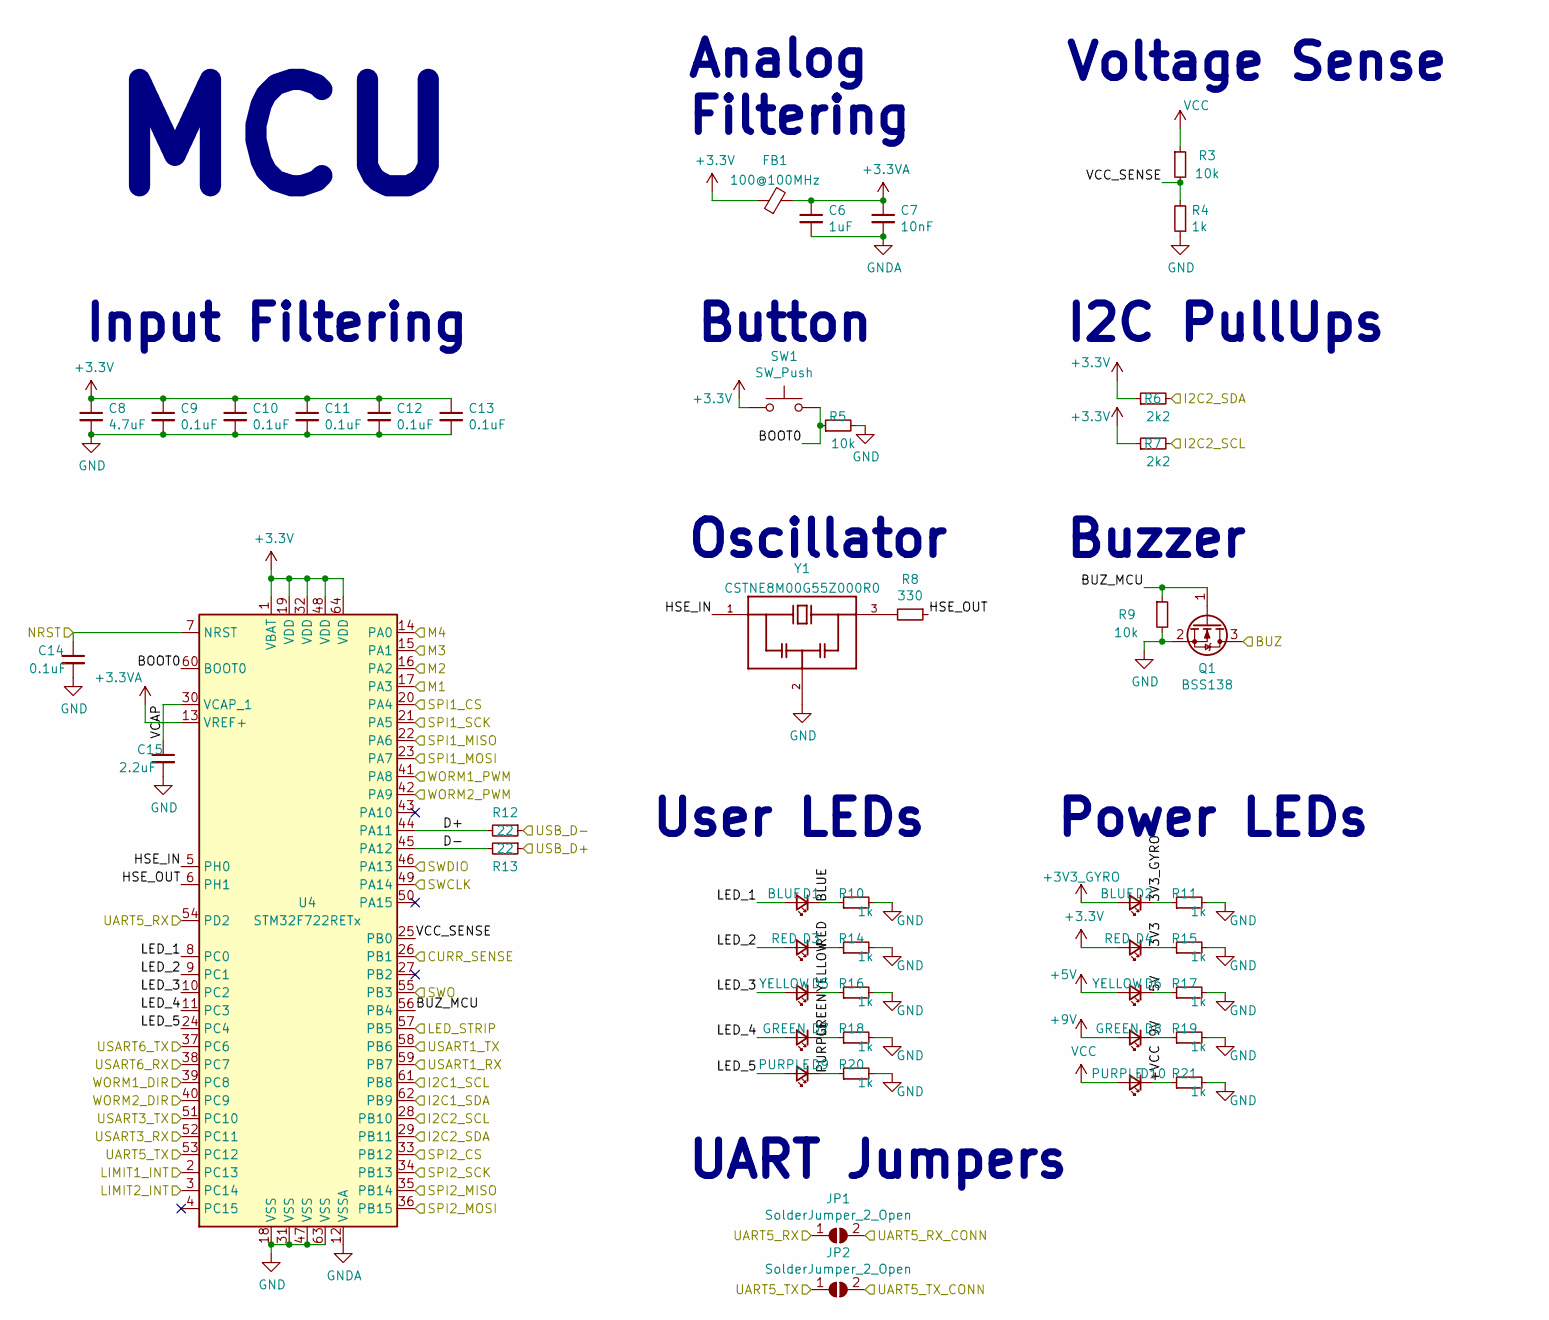
[picture p23: schematic MCU.kicad_sch]

Parts:
C6: 1uF; C_0402_1005Metric
C7: 10nF; C_0402_1005Metric
C8: 4.7uF; C_0402_1005Metric
C9, C10, C11, C12, C13, C14: 0.1uF; C_0402_1005Metric
C15: 2.2uF; C_0402_1005Metric
D1, D2: BLUE; LED_0603_1608Metric
D3, D4: RED; LED_0603_1608Metric
D5, D6: YELLOW; LED_0603_1608Metric
D7, D8: GREEN; LED_0603_1608Metric
D9, D10: PURPLE; LED_0603_1608Metric
FB1: 100@100MHz; L_0603_1608Metric
JP1, JP2: SolderJumper_2_Open; SolderJumper-2_P1.3mm_Open_TrianglePad1.0x1.5mm
Q1: BSS138; SOT-23
R3, R5, R9: 10k; R_0402_1005Metric
R4, R10, R11, R14, R15, R16, R17, R18, R19, R20, R21: 1k; R_0402_1005Metric
R6, R7: 2k2; R_0402_1005Metric
R8: 330; R_0402_1005Metric
R12, R13: 22; R_0402_1005Metric
SW1: SW_Push; SW_SPST_B3U-1000P
U4: STM32F722RETx; LQFP-64_10x10mm_P0.5mm
Y1: CSTNE8M00G55Z000R0; OSC_CSTNE8M00G55Z000R0; PARTREV JGC42-8858A

Connections:
+3.3VA: C6.1, C7.1, FB1.2, U4.13 (VREF+)
+3V3_GYRO: D2.2 (A); also elsewhere on the board
+5V: D6.2 (A); also elsewhere on the board
+9V: D8.2 (A); also elsewhere on the board
/Barometer/I2C1_SCL: U4.61 (PB8); also elsewhere on the board
/Barometer/I2C1_SDA: U4.62 (PB9); also elsewhere on the board
/Connectors/BUZ: Q1.3 (D); also elsewhere on the board
/Connectors/CURR_SENSE: U4.26 (PB1); also elsewhere on the board
/Connectors/I2C2_SCL: R7.2, U4.28 (PB10); also elsewhere on the board
/Connectors/I2C2_SDA: R6.2, U4.29 (PB11); also elsewhere on the board
/Connectors/LED_STRIP: U4.57 (PB5); also elsewhere on the board
/Connectors/LIMIT1_INT: U4.2 (PC13); also elsewhere on the board
/Connectors/LIMIT2_INT: U4.3 (PC14); also elsewhere on the board
/Connectors/M1: U4.17 (PA3); also elsewhere on the board
/Connectors/M2: U4.16 (PA2); also elsewhere on the board
/Connectors/M3: U4.15 (PA1); also elsewhere on the board
/Connectors/M4: U4.14 (PA0); also elsewhere on the board
/Connectors/UART5_RX_CONN: JP1.2 (B); also elsewhere on the board
/Connectors/UART5_TX_CONN: JP2.2 (B); also elsewhere on the board
/Connectors/USART1_RX: U4.59 (PB7); also elsewhere on the board
/Connectors/USART1_TX: U4.58 (PB6); also elsewhere on the board
/Connectors/USART3_RX: U4.52 (PC11); also elsewhere on the board
/Connectors/USART3_TX: U4.51 (PC10); also elsewhere on the board
/Connectors/USART6_RX: U4.38 (PC7); also elsewhere on the board
/Connectors/USART6_TX: U4.37 (PC6); also elsewhere on the board
/Connectors/USB_D+: R13.1; also elsewhere on the board
/Connectors/USB_D-: R12.1; also elsewhere on the board
/Debugger/NRST: C14.1, U4.7 (NRST); also elsewhere on the board
/Debugger/SWCLK: U4.49 (PA14); also elsewhere on the board
/Debugger/SWDIO: U4.46 (PA13); also elsewhere on the board
/Debugger/SWO: U4.55 (PB3); also elsewhere on the board
/Debugger/VCP_RX: JP1.1 (A), U4.54 (PD2); also elsewhere on the board
/Debugger/VCP_TX: JP2.1 (A), U4.53 (PC12); also elsewhere on the board
/Gyro/SPI1_CS: U4.20 (PA4); also elsewhere on the board
/Gyro/SPI1_MISO: U4.22 (PA6); also elsewhere on the board
/Gyro/SPI1_MOSI: U4.23 (PA7); also elsewhere on the board
/Gyro/SPI1_SCK: U4.21 (PA5); also elsewhere on the board
/MCU/3V3: D4.1 (K), R15.1
/MCU/3V3_GYRO: D2.1 (K), R11.1
/MCU/5V: D6.1 (K), R17.1
/MCU/9V: D8.1 (K), R19.1
/MCU/+VCC: D10.1 (K), R21.1
/MCU/BLUE: D1.1 (K), R10.1
/MCU/BOOT0: R5.1, SW1.2, U4.60 (BOOT0)
/MCU/BUZ_MCU: Q1.1 (G), R9.1, U4.56 (PB4)
/MCU/D+: R12.2, U4.44 (PA11)
/MCU/D-: R13.2, U4.45 (PA12)
/MCU/GREEN: D7.1 (K), R18.1
/MCU/HSE_IN: U4.5 (PH0), Y1.1
/MCU/HSE_OUT: R8.1, U4.6 (PH1)
/MCU/LED_1: D1.2 (A), U4.8 (PC0)
/MCU/LED_2: D3.2 (A), U4.9 (PC1)
/MCU/LED_3: D5.2 (A), U4.10 (PC2)
/MCU/LED_4: D7.2 (A), U4.11 (PC3)
/MCU/LED_5: D9.2 (A), U4.24 (PC4)
/MCU/PURPLE: D9.1 (K), R20.1
/MCU/RED: D3.1 (K), R14.1
/MCU/SPI2_CS: U4.33 (PB12); also elsewhere on the board
/MCU/SPI2_MISO: U4.35 (PB14); also elsewhere on the board
/MCU/SPI2_MOSI: U4.36 (PB15); also elsewhere on the board
/MCU/SPI2_SCK: U4.34 (PB13); also elsewhere on the board
/MCU/VCAP: C15.1, U4.30 (VCAP_1)
/MCU/VCC_SENSE: R3.2, R4.2, U4.25 (PB0)
/MCU/WORM1_DIR: U4.39 (PC8); also elsewhere on the board
/MCU/WORM1_PWM: U4.41 (PA8); also elsewhere on the board
/MCU/WORM2_DIR: U4.40 (PC9); also elsewhere on the board
/MCU/WORM2_PWM: U4.42 (PA9); also elsewhere on the board
/MCU/YELLOW: D5.1 (K), R16.1
GND: C8.2, C9.2, C10.2, C11.2, C12.2, C13.2, C14.2, C15.2, Q1.2 (S), R4.1, R5.2, R9.2, R10.2, R11.2, R14.2, R15.2, R16.2, R17.2, R18.2, R19.2, R20.2, R21.2, U4.18 (VSS), U4.31 (VSS), U4.47 (VSS), U4.63 (VSS), Y1.2; also elsewhere on the board
GNDA: C6.2, C7.2, U4.12 (VSSA)
unnamed: R8.2, Y1.3
VCC: D10.2 (A), R3.1; also elsewhere on the board

Notes on the sheet:
MCU
User LEDs
Buzzer
UART Jumpers
Analog Filtering
Input Filtering
Oscillator
I2C PullUps
Button
Voltage Sense
Power LEDs

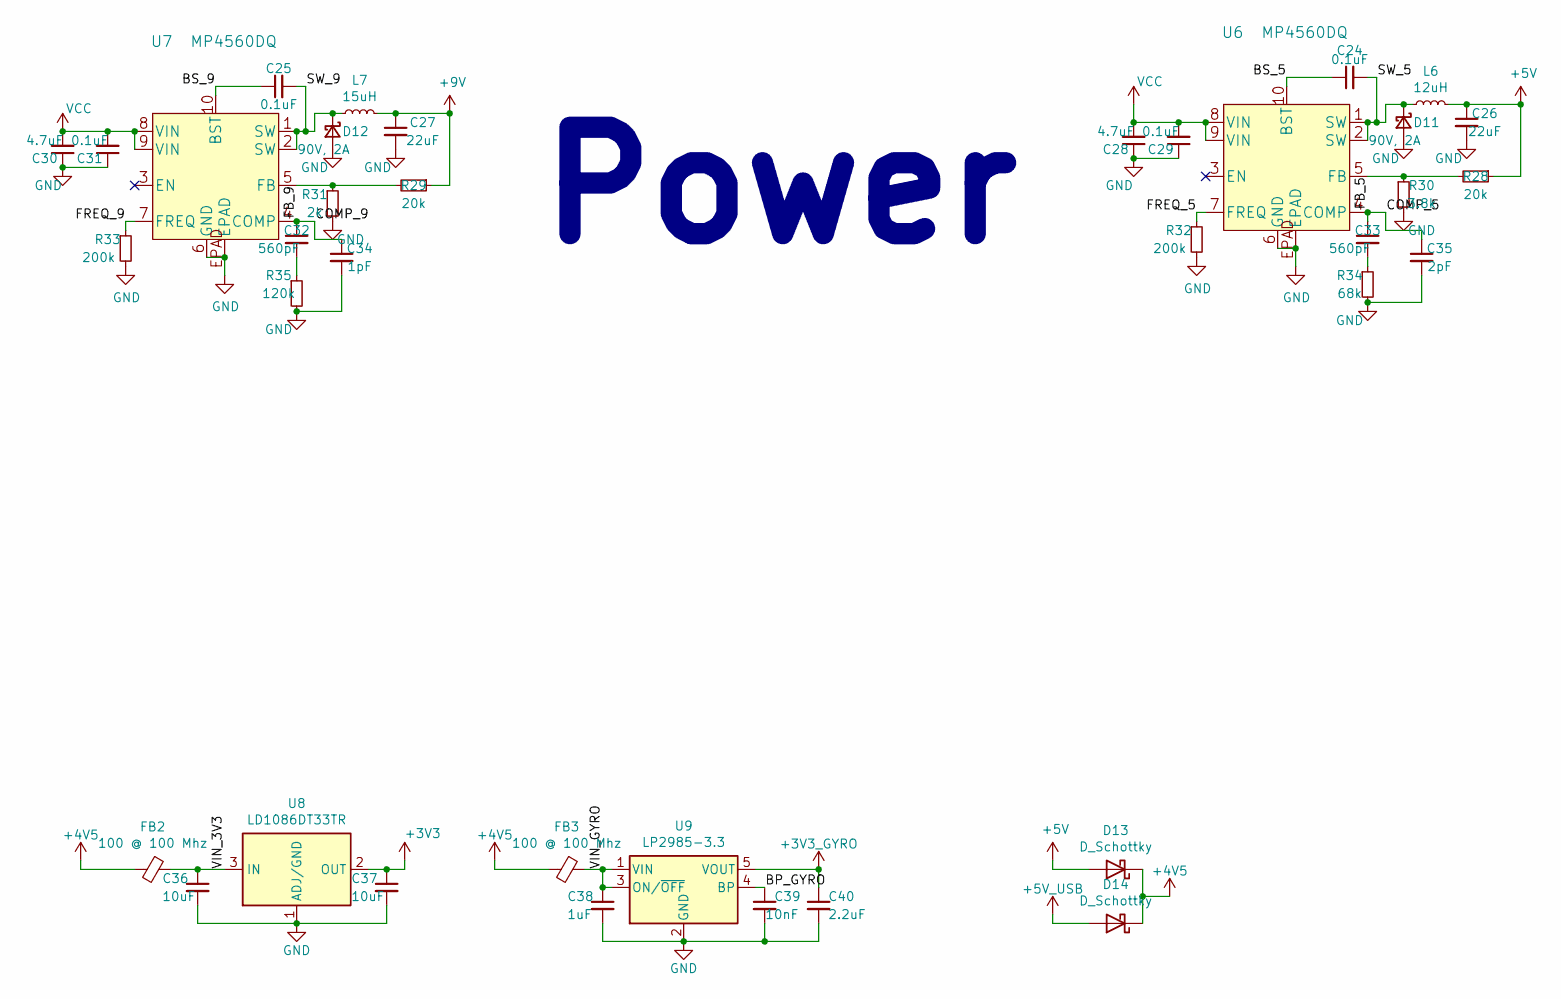
[picture p24: schematic Power.kicad_sch]

Parts:
C24, C25, C29, C31: 0.1uF; C_0402_1005Metric
C26, C27: 22uF; C_0805_2012Metric
C28, C30: 4.7uF; C_0402_1005Metric
C32, C33: 560pF; C_0402_1005Metric
C34: 1pF; C_0402_1005Metric
C35: 2pF; C_0402_1005Metric
C36, C37: 10uF; C_0402_1005Metric
C38: 1uF; C_0402_1005Metric
C39: 10nF; C_0402_1005Metric
C40: 2.2uF; C_0402_1005Metric
D11, D12: 90V, 2A; D_SOD-123F
D13, D14: D_Schottky; D_SOD-123F
FB2, FB3: 100 @ 100 Mhz; L_0603_1608Metric
L6: 12uH; L_Bourns_SRN3015
L7: 15uH; L_Bourns_SRN3015
R28, R29: 20k; R_0402_1005Metric
R30: 3.8k; R_0402_1005Metric
R31: 2k; R_0402_1005Metric
R32, R33: 200k; R_0402_1005Metric
R34: 68k; R_0402_1005Metric
R35: 120k; R_0402_1005Metric
U6, U7: MP4560DQ
U8: LD1086DT33TR; TO-252-2
U9: LP2985-3.3; SOT-23-5

Connections:
+3V3_GYRO: C40.1, U9.5 (VOUT); also elsewhere on the board
+4V5: D13.1 (K), D14.1 (K), FB2.2, FB3.2; also elsewhere on the board
+5V: C26.1, D13.2 (A), L6.2, R28.1; also elsewhere on the board
+5V_USB: D14.2 (A); also elsewhere on the board
+9V: C27.1, L7.2, R29.1; also elsewhere on the board
/Power/BP_GYRO: C39.1, U9.4 (BP)
/Power/BS_5: C24.1, U6.10 (BST)
/Power/BS_9: C25.1, U7.10 (BST)
/Power/COMP_5: C33.1, C35.1, U6.4 (COMP)
/Power/COMP_9: C32.1, C34.1, U7.4 (COMP)
/Power/FB_5: R28.2, R30.1, U6.5 (FB)
/Power/FB_9: R29.2, R31.1, U7.5 (FB)
/Power/FREQ_5: R32.1, U6.7 (FREQ)
/Power/FREQ_9: R33.1, U7.7 (FREQ)
/Power/SW_5: C24.2, D11.1 (K), L6.1, U6.1 (SW), U6.2 (SW)
/Power/SW_9: C25.2, D12.1 (K), L7.1, U7.1 (SW), U7.2 (SW)
/Power/VIN_3V3: C36.1, FB2.1, U8.3 (IN)
/Power/VIN_GYRO: C38.1, FB3.1, U9.1 (VIN), U9.3 (ON/~OFF)
GND: C26.2, C27.2, C28.1, C29.1, C30.1, C31.1, C34.2, C35.2, C36.2, C37.2, C38.2, C39.2, C40.2, D11.2 (A), D12.2 (A), R30.2, R31.2, R32.2, R33.2, R34.2, R35.2, U6.6 (GND), U6.EPAD, U7.6 (GND), U7.EPAD, U8.1 (ADJ/GND), U9.2 (GND); also elsewhere on the board
unnamed: C32.2, R35.1
unnamed: C33.2, R34.1
VCC: C28.2, C29.2, C30.2, C31.2, U6.8 (VIN), U6.9 (VIN), U7.8 (VIN), U7.9 (VIN); also elsewhere on the board

Notes on the sheet:
Power

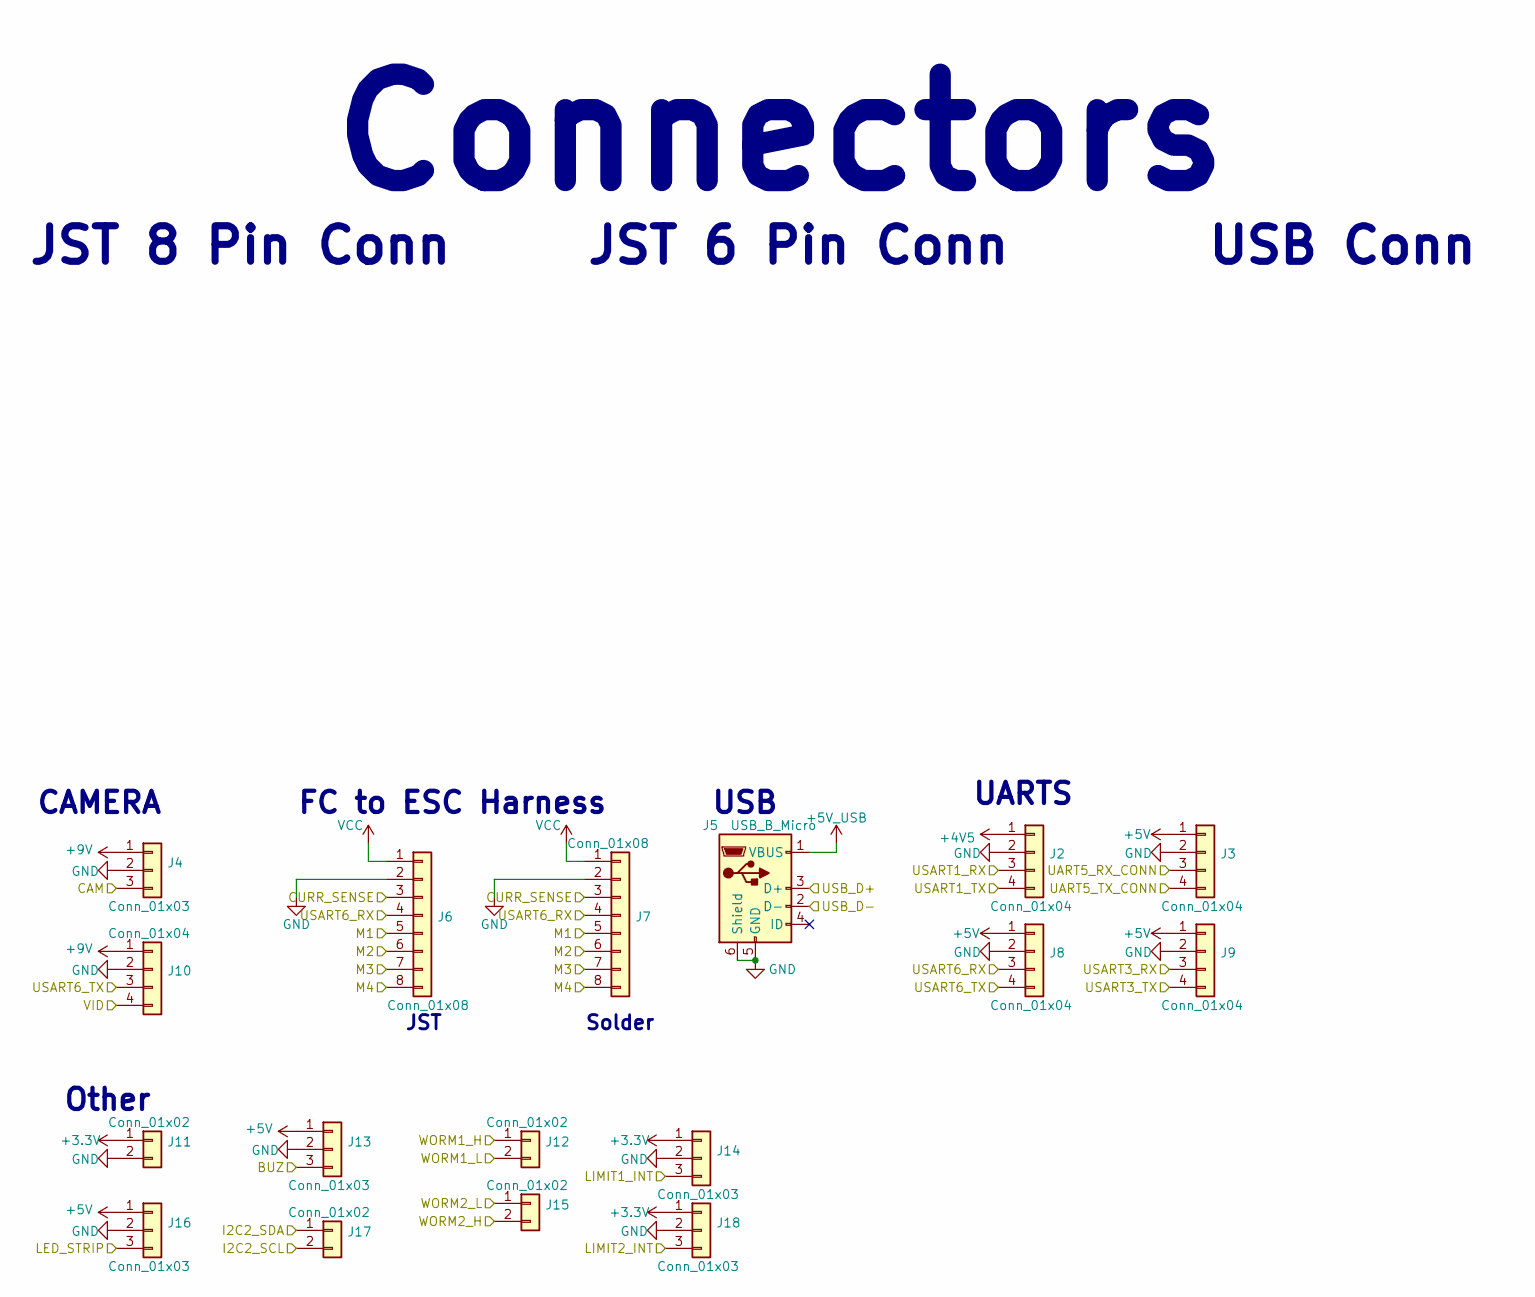
[picture p25: schematic Connectors.kicad_sch]

Parts:
J2, J3, J8, J9, J10: Conn_01x04; Conn_1x4
J4, J13, J14, J16, J18: Conn_01x03; Conn_1x3
J5: USB_B_Micro; USB_Micro-B_Amphenol_10103594-0001LF_Horizontal
J6: Conn_01x08; JST_SH_SM08B-SRSS-TB_1x08-1MP_P1.00mm_Horizontal
J7: Conn_01x08; Conn_8Edge
J11, J17: Conn_01x02; Conn_1x2
J12: Conn_01x02; Conn_Motor1
J15: Conn_01x02; Conn_Motor2

Connections:
+4V5: J2.1; also elsewhere on the board
+5V: J3.1, J8.1, J9.1, J13.1, J16.1; also elsewhere on the board
+5V_USB: J5.1 (VBUS); also elsewhere on the board
+9V: J4.1, J10.1; also elsewhere on the board
/CAM: J4.3; also elsewhere on the board
/Connectors/BUZ: J13.3; also elsewhere on the board
/Connectors/CURR_SENSE: J6.3, J7.3; also elsewhere on the board
/Connectors/I2C2_SCL: J17.2; also elsewhere on the board
/Connectors/I2C2_SDA: J17.1; also elsewhere on the board
/Connectors/LED_STRIP: J16.3; also elsewhere on the board
/Connectors/LIMIT1_INT: J14.3; also elsewhere on the board
/Connectors/LIMIT2_INT: J18.3; also elsewhere on the board
/Connectors/M1: J6.5, J7.5; also elsewhere on the board
/Connectors/M2: J6.6, J7.6; also elsewhere on the board
/Connectors/M3: J6.7, J7.7; also elsewhere on the board
/Connectors/M4: J6.8, J7.8; also elsewhere on the board
/Connectors/UART5_RX_CONN: J3.3; also elsewhere on the board
/Connectors/UART5_TX_CONN: J3.4; also elsewhere on the board
/Connectors/USART1_RX: J2.3; also elsewhere on the board
/Connectors/USART1_TX: J2.4; also elsewhere on the board
/Connectors/USART3_RX: J9.3; also elsewhere on the board
/Connectors/USART3_TX: J9.4; also elsewhere on the board
/Connectors/USART6_RX: J6.4, J7.4, J8.3; also elsewhere on the board
/Connectors/USART6_TX: J8.4, J10.3; also elsewhere on the board
/Connectors/USB_D+: J5.3 (D+); also elsewhere on the board
/Connectors/USB_D-: J5.2 (D-); also elsewhere on the board
/VID: J10.4; also elsewhere on the board
/WORM1_H: J12.1; also elsewhere on the board
/WORM1_L: J12.2; also elsewhere on the board
/WORM2_H: J15.2; also elsewhere on the board
/WORM2_L: J15.1; also elsewhere on the board
GND: J2.2, J3.2, J4.2, J5.5 (GND), J5.6 (Shield), J6.2, J7.2, J8.2, J9.2, J10.2, J11.2, J13.2, J14.2, J16.2, J18.2; also elsewhere on the board
VCC: J6.1, J7.1; also elsewhere on the board

Notes on the sheet:
USB
Solder
JST 8 Pin Conn
JST
CAMERA
UARTS
Connectors
FC to ESC Harness
Other
JST 6 Pin Conn
USB Conn

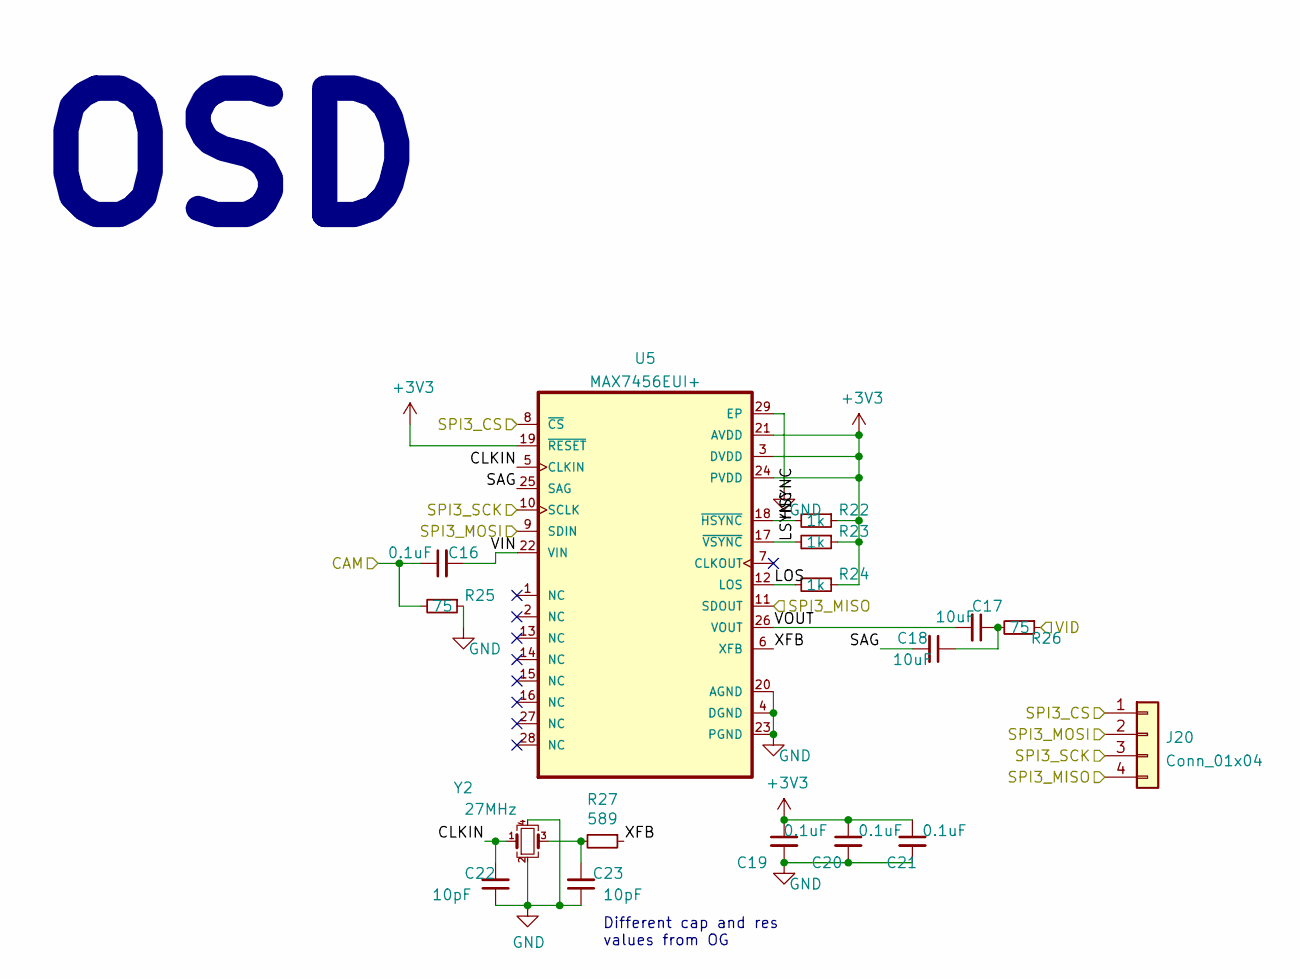
[picture p26: schematic OSD.kicad_sch]

Parts:
C16, C19, C20, C21: 0.1uF; C_0402_1005Metric
C17, C18: 10uF; C_0402_1005Metric
C22, C23: 10pF; C_0402_1005Metric
J20: Conn_01x04; SPI_Probe
R22, R23, R24: 1k; R_0402_1005Metric
R25, R26: 75; R_0402_1005Metric
R27: 589; R_0402_1005Metric
U5: MAX7456EUI+; MAX7456
Y2: 27MHz; Oscillator_SMD_Abracon_ASE-4Pin_3.2x2.5mm

Connections:
/CAM: C16.1, R25.2; also elsewhere on the board
/MCU/SPI2_CS: J20.1, U5.8 (~CS); also elsewhere on the board
/MCU/SPI2_MISO: J20.4, U5.11 (SDOUT); also elsewhere on the board
/MCU/SPI2_MOSI: J20.2, U5.9 (SDIN); also elsewhere on the board
/MCU/SPI2_SCK: J20.3, U5.10 (SCLK); also elsewhere on the board
/OSD/CLKIN: C22.2, U5.5 (CLKIN), Y2.1
/OSD/HSYNC: R22.2, U5.18 (~HSYNC)
/OSD/LOS: R24.2, U5.12 (LOS)
/OSD/LSYNC: R23.2, U5.17 (~VSYNC)
/OSD/SAG: C18.2, U5.25 (SAG)
/OSD/VIN: C16.2, U5.22 (VIN)
/OSD/VOUT: C17.2, U5.26 (VOUT)
/OSD/XFB: R27.1, U5.6 (XFB)
/VID: R26.1; also elsewhere on the board
GND: C19.2, C20.2, C21.2, C22.1, C23.1, R25.1, U5.4 (DGND), U5.20 (AGND), U5.23 (PGND), U5.29 (EP), Y2.2, Y2.4; also elsewhere on the board
unnamed: C17.1, C18.1, R26.2
unnamed: C23.2, R27.2, Y2.3

Notes on the sheet:
Different cap and res values from OG
OSD

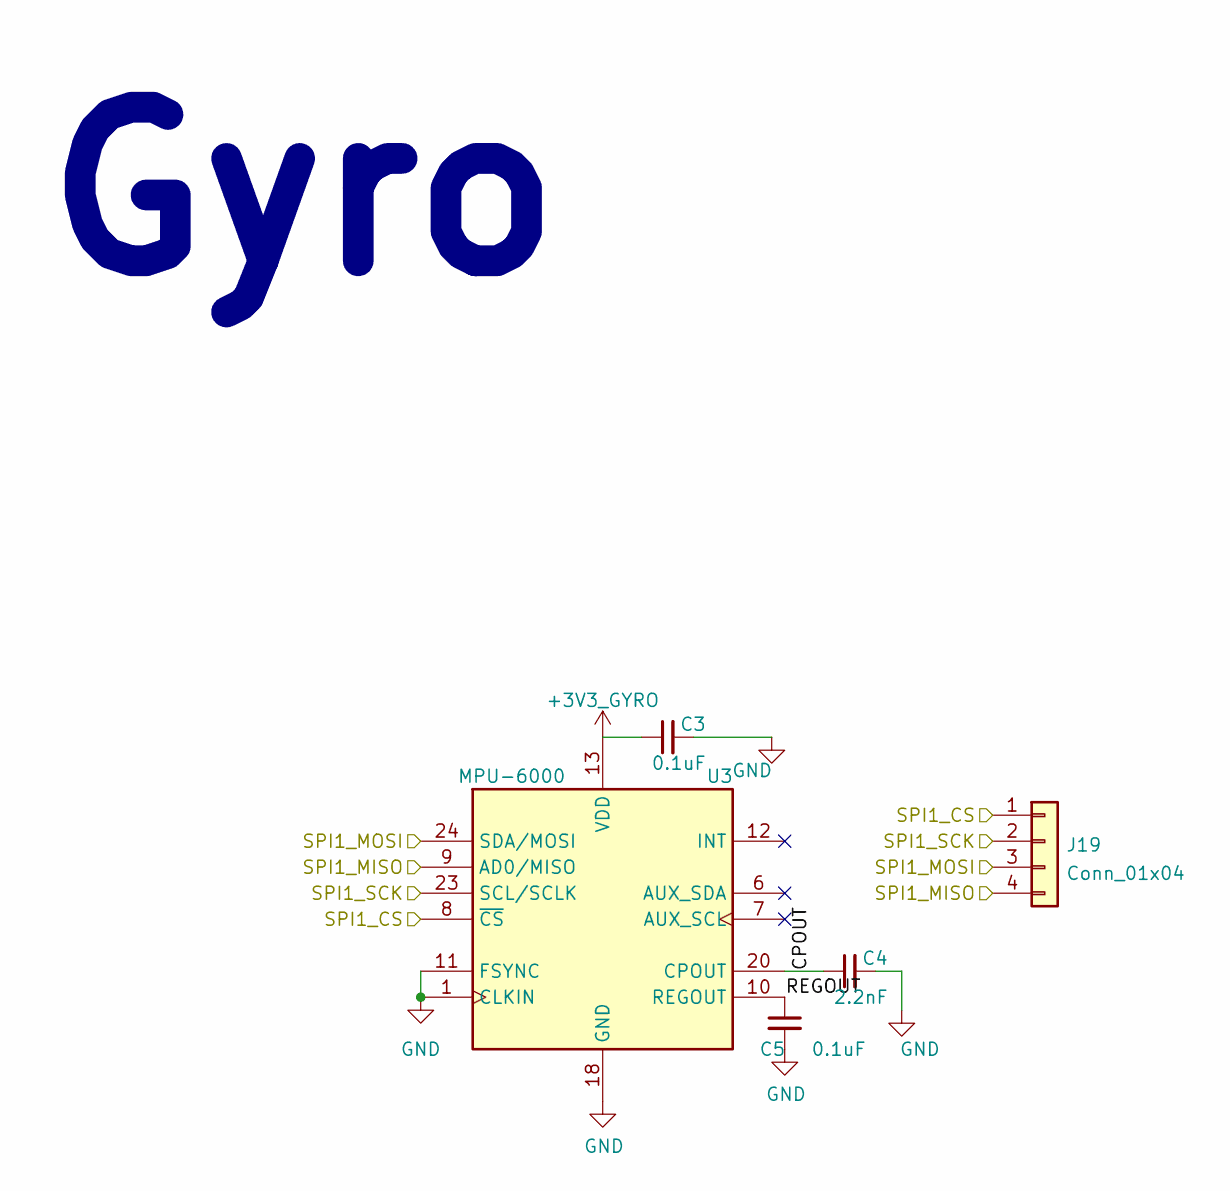
[picture p27: schematic Gyro.kicad_sch]

Parts:
C3, C5: 0.1uF; C_0402_1005Metric
C4: 2.2nF; C_0402_1005Metric
J19: Conn_01x04; SPI_Probe
U3: MPU-6000; InvenSense_QFN-24_4x4mm_P0.5mm

Connections:
+3V3_GYRO: C3.1, U3.13 (VDD); also elsewhere on the board
/Gyro/CPOUT: C4.1, U3.20 (CPOUT)
/Gyro/REGOUT: C5.1, U3.10 (REGOUT)
/Gyro/SPI1_CS: J19.1, U3.8 (~CS); also elsewhere on the board
/Gyro/SPI1_MISO: J19.4, U3.9 (AD0/MISO); also elsewhere on the board
/Gyro/SPI1_MOSI: J19.3, U3.24 (SDA/MOSI); also elsewhere on the board
/Gyro/SPI1_SCK: J19.2, U3.23 (SCL/SCLK); also elsewhere on the board
GND: C3.2, C4.2, C5.2, U3.1 (CLKIN), U3.11 (FSYNC), U3.18 (GND); also elsewhere on the board

Notes on the sheet:
Gyro

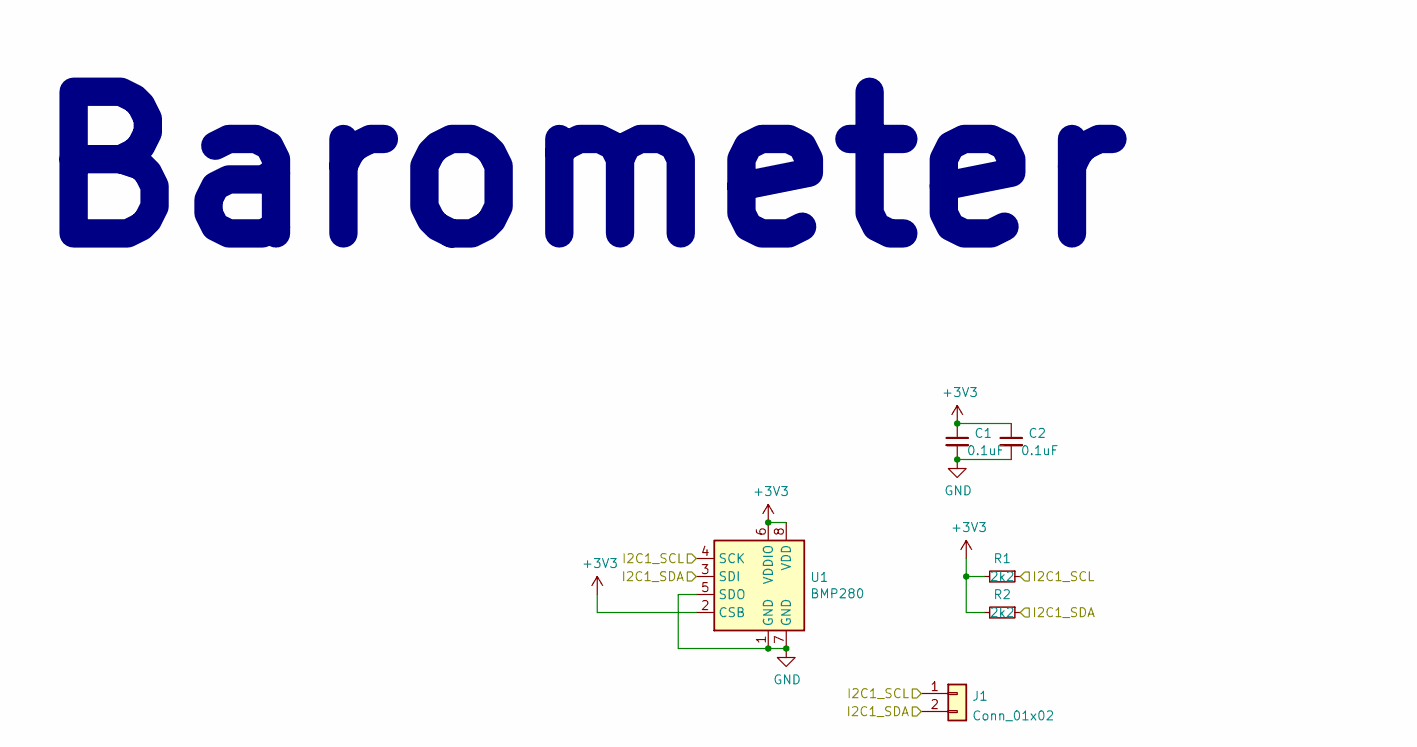
[picture p28: schematic Barometer.kicad_sch]

Parts:
C1, C2: 0.1uF; C_0402_1005Metric
J1: Conn_01x02; I2C_Probe
R1, R2: 2k2; R_0402_1005Metric
U1: BMP280; Bosch_LGA-8_2x2.5mm_P0.65mm_ClockwisePinNumbering

Connections:
/Barometer/I2C1_SCL: J1.1, R1.1, U1.4 (SCK); also elsewhere on the board
/Barometer/I2C1_SDA: J1.2, R2.1, U1.3 (SDI); also elsewhere on the board
GND: C1.2, C2.2, U1.1 (GND), U1.5 (SDO), U1.7 (GND); also elsewhere on the board

Notes on the sheet:
Barometer

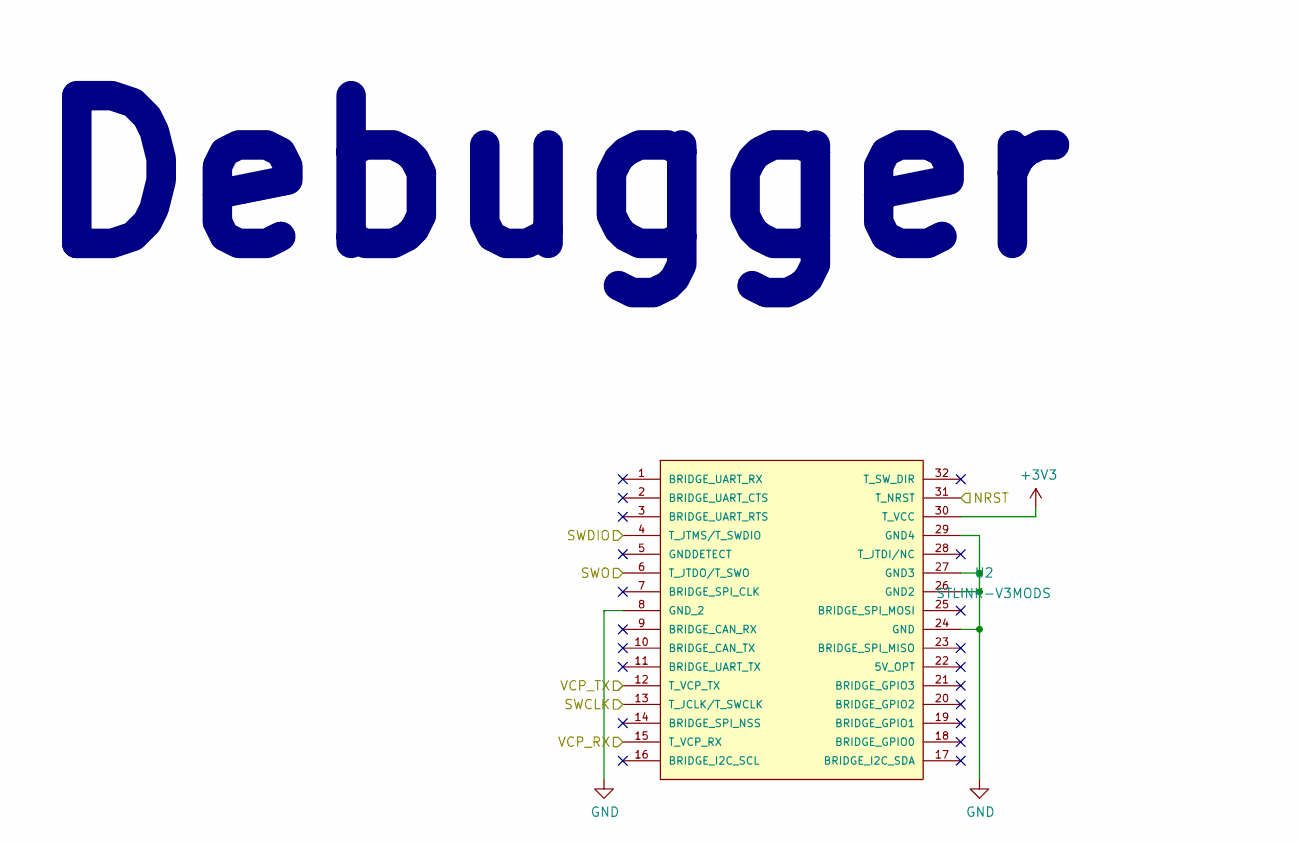
[picture p29: schematic Debugger.kicad_sch]

Parts:
U2: STLINK-V3MODS; STLINKV3MODS; MANUFACTURER_PART_NUMBER STLINKV3MOS

Connections:
/Debugger/NRST: U2.31 (T_NRST); also elsewhere on the board
/Debugger/SWCLK: U2.13 (T_JCLK/T_SWCLK); also elsewhere on the board
/Debugger/SWDIO: U2.4 (T_JTMS/T_SWDIO); also elsewhere on the board
/Debugger/SWO: U2.6 (T_JTDO/T_SWO); also elsewhere on the board
/Debugger/VCP_RX: U2.15 (T_VCP_RX); also elsewhere on the board
/Debugger/VCP_TX: U2.12 (T_VCP_TX); also elsewhere on the board
GND: U2.8 (GND_2), U2.24 (GND), U2.26 (GND2), U2.27 (GND3), U2.29 (GND4); also elsewhere on the board

Notes on the sheet:
Debugger

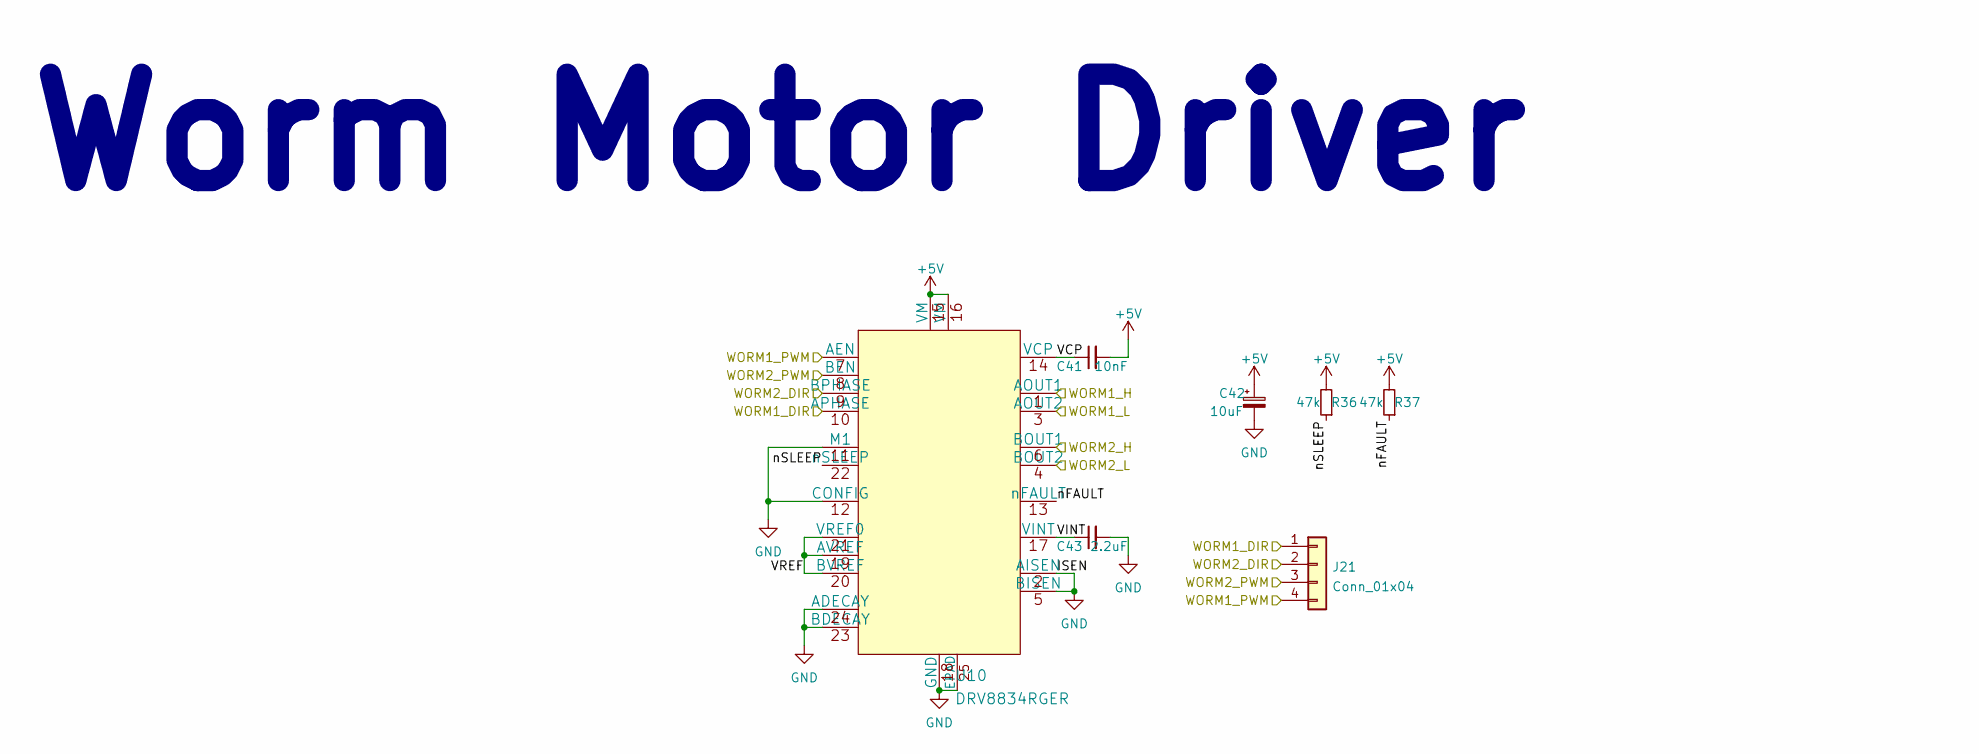
[picture p30: schematic WormDriver.kicad_sch]

Parts:
C41: 10nF; C_0402_1005Metric
C42: 10uF; CP_EIA-1608-08_AVX-J
C43: 2.2uF; C_0402_1005Metric
J21: Conn_01x04; SPI_Probe
R36, R37: 47k; R_0402_1005Metric
U10: DRV8834RGER

Connections:
+5V: C41.2, C42.1, R36.2, R37.2, U10.15 (VM), U10.16 (VM); also elsewhere on the board
/MCU/WORM1_DIR: J21.1, U10.10 (APHASE); also elsewhere on the board
/MCU/WORM1_PWM: J21.4, U10.7 (AEN); also elsewhere on the board
/MCU/WORM2_DIR: J21.2, U10.9 (BPHASE); also elsewhere on the board
/MCU/WORM2_PWM: J21.3, U10.8 (BEN); also elsewhere on the board
/WORM1_H: U10.1 (AOUT1); also elsewhere on the board
/WORM1_L: U10.3 (AOUT2); also elsewhere on the board
/WORM2_H: U10.6 (BOUT1); also elsewhere on the board
/WORM2_L: U10.4 (BOUT2); also elsewhere on the board
/WormDriver/VCP: C41.1, U10.14 (VCP)
/WormDriver/VINT: C43.1, U10.17 (VINT)
/WormDriver/VREF: U10.19 (AVREF), U10.20 (BVREF), U10.21 (VREF0)
/WormDriver/nFAULT: R37.1, U10.13 (nFAULT)
/WormDriver/nSLEEP: R36.1, U10.22 (nSLEEP)
GND: C42.2, C43.2, U10.2 (AISEN), U10.5 (BISEN), U10.11 (M1), U10.12 (CONFIG), U10.18 (GND), U10.23 (BDECAY), U10.24 (ADECAY), U10.25 (EPAD); also elsewhere on the board

Notes on the sheet:
Worm Motor Driver

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
