Jpwolfe9912/Autodrone_V2/Autodrone_V2.kicad_pcb

## KiCad design Autodrone_V2.kicad_pcb (continued)

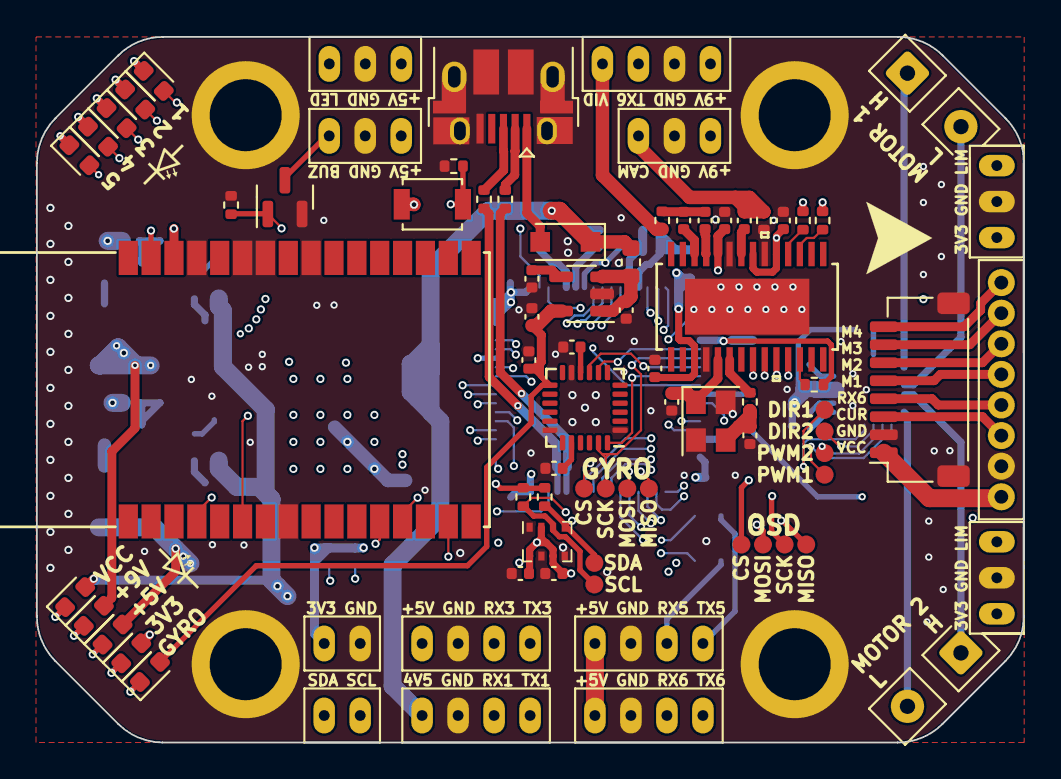
[picture p31: board Autodrone_V2.kicad_pcb from above]

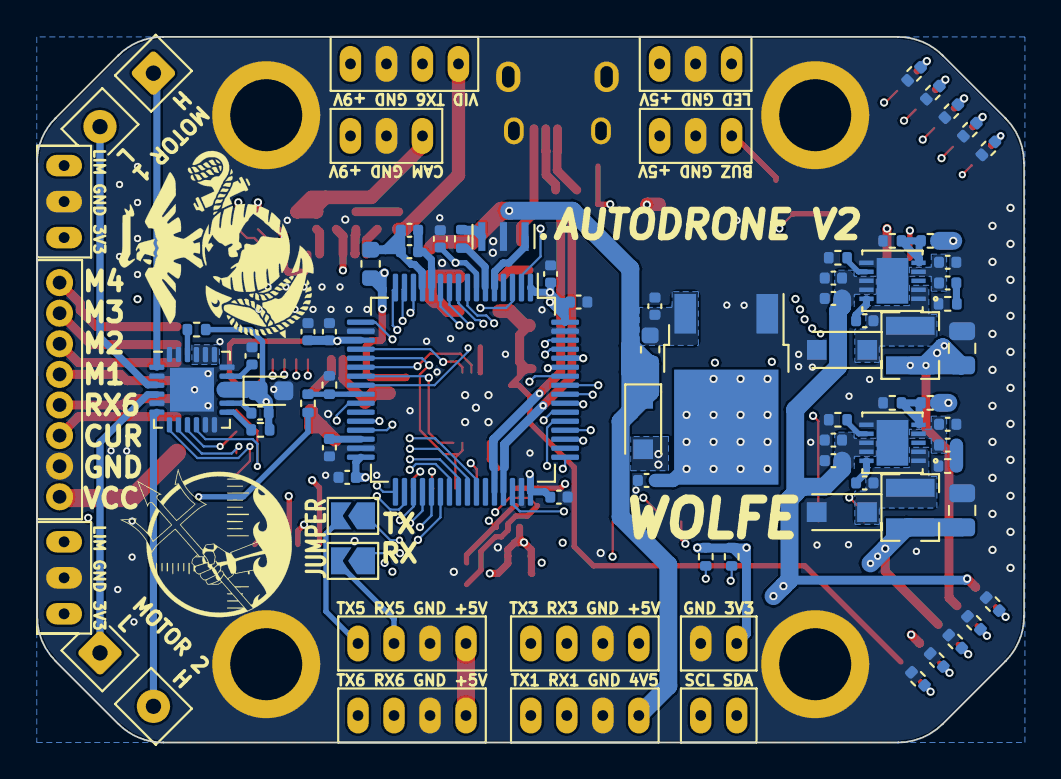
[picture p32: board Autodrone_V2.kicad_pcb from below]

Board: 6 copper layers, 54.8 x 39.2 mm, 145 parts (69 on the bottom side), 113 nets.
