Jpwolfe9912/Autodrone_V2/(commit log)

2022-01-02 Adding all new files
    [Autodrone_V2.kicad_pcb, Autodrone_V2.kicad_sch, Autodrone_V2.sch, Barometer.kicad_sch, Barometer.sch, Connectors.kicad_sch, Connectors.sch, Debugger.kicad_sch]
2022-01-02 Updated PDF of schematic
    [Autodrone_V2.kicad_sch]
2022-01-26 I guess I made some changes
    [Autodrone_V2.kicad_pcb, Autodrone_V2.kicad_sch, Autodrone_V2.sch, Barometer.kicad_sch, Barometer.sch, Connectors.kicad_sch, Connectors.sch, Debugger.kicad_sch]
2022-04-11 Added new files
    [Autodrone_V2-B_Mask.gbs, Autodrone_V2-B_Paste.gbp, Autodrone_V2-B_Silkscreen.gbo, Autodrone_V2-Edge_Cuts.gm1, Autodrone_V2-F_Mask.gts, Autodrone_V2-F_Paste.gtp, Autodrone_V2-F_Silkscreen.gto, Autodrone_V2-Signal1.gtl]
